cdrfiuba/marciano/src/README

Instalar libmanyuc en un directorio a la misma altura que el repositorio de Marciano
