cdrfiuba/marciano/src/eyes/MatthewPandina/schematics/README

Demystifying the TLC5940 - gEDA schematics

The schematics in the book were created using gEDA
(http://www.gpleda.org/), which is a set of electronic design
automation tools available for free under the GPL license.

Open the .sch files using gschem.
