cdrfiuba/marciano/src/eyes/MatthewPandina/code/ch3/README

Demystifying the TLC5940 - Chapter 3

Instructions:

  1. Verify that DEVICE, CLOCK, PROGRAMMER, and FUSES are set
     correctly in the Makefile based on your hardware. The provided
     Makefile is configured for an ATmega328P running at 18.432 MHz,
     using an AVR ISP mkII programmer, with FUSES set to remove the
     clock divider, and to use the external crystal.

  2. To build, type `make`

  3. To set the fuse bits, type `make fuse`

  4. To program the AVR, type `make flash`
