cdrfiuba/marciano/scad/orbitron.dxf

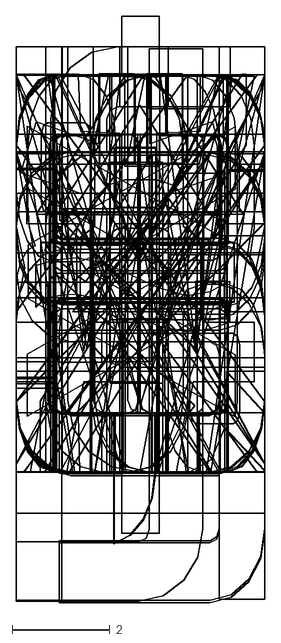
[picture p1: CAD file, 2015-04-26]
scad/orbitron.dxf
5.08 x 12.0
