cdrfiuba/marciano/(list of files, cad)

Other CAD files:
scad/Letters.dxf
scad/Write.scad
