cdrfiuba/marciano/src/eyes/MatthewPandina/schematics/multiplexing-multi.pdf

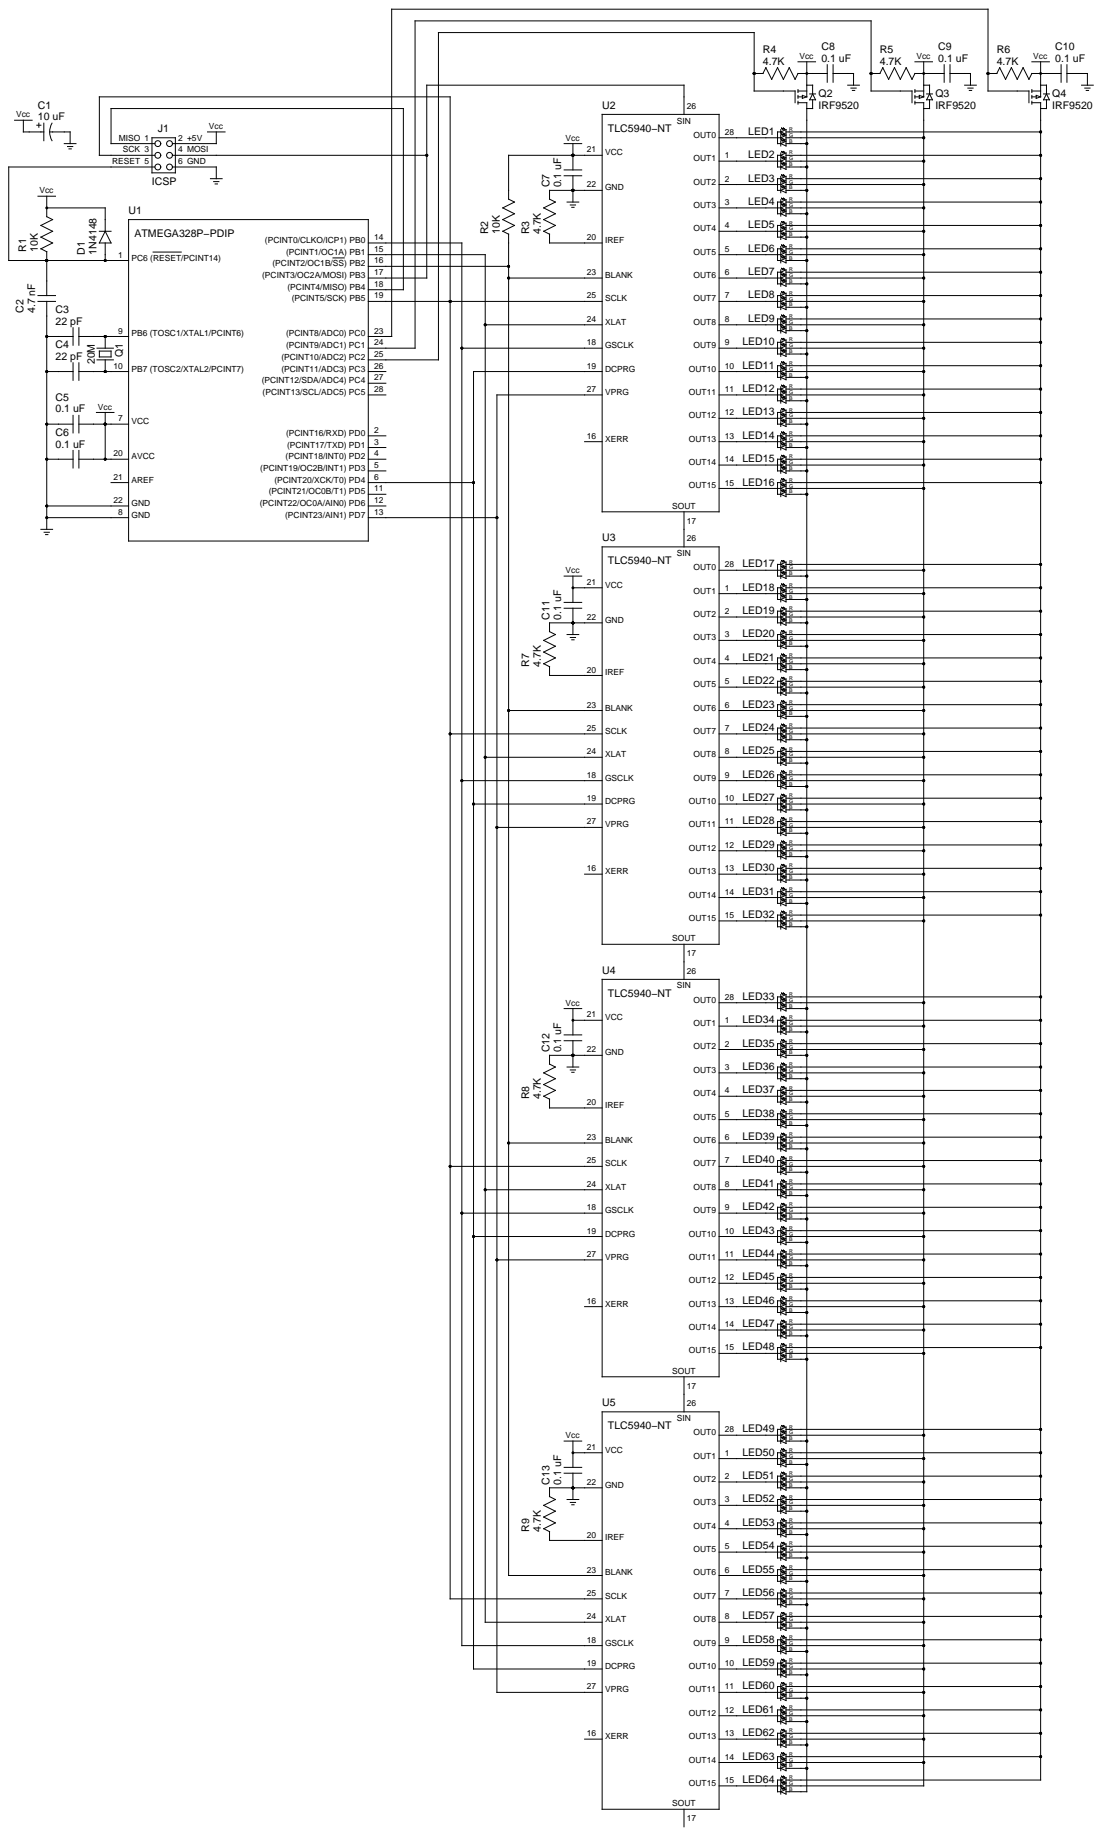
[picture p2: page 1]
