cdrfiuba/marciano/src/eyes/MatthewPandina/schematics/multiplexing.pdf

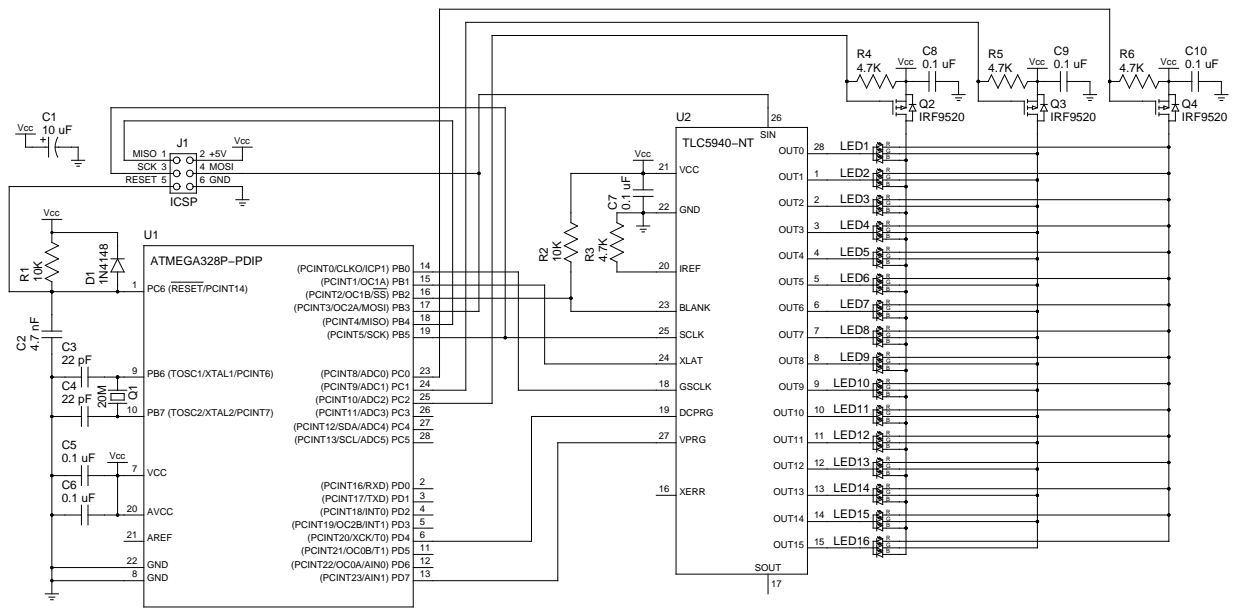
[picture p3: page 1]

15 (PCINT1/OC1A) PB1
16 (PCINT2/OC1B/SS) PB2
17 (PCINT3/OC2A/MOSI) PB3
18 (PCINT4/MISO) PB4
