cdrfiuba/marciano/src/eyes/MatthewPandina/schematics/no_border.pdf

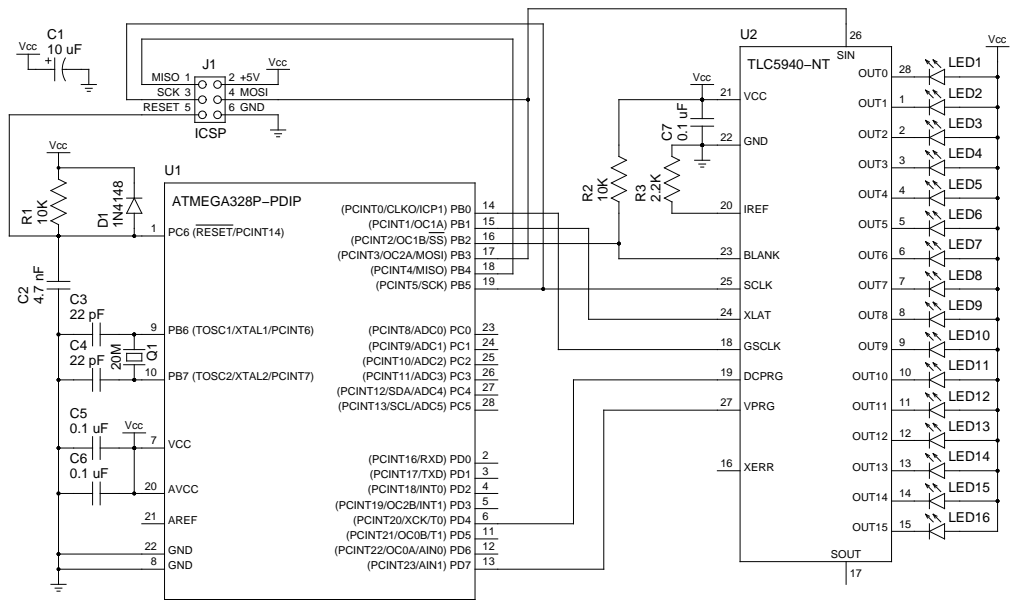
[picture p4: page 1]
