cdrfiuba/marciano/src/eyes/MatthewPandina/schematics/no_border_multiple.pdf

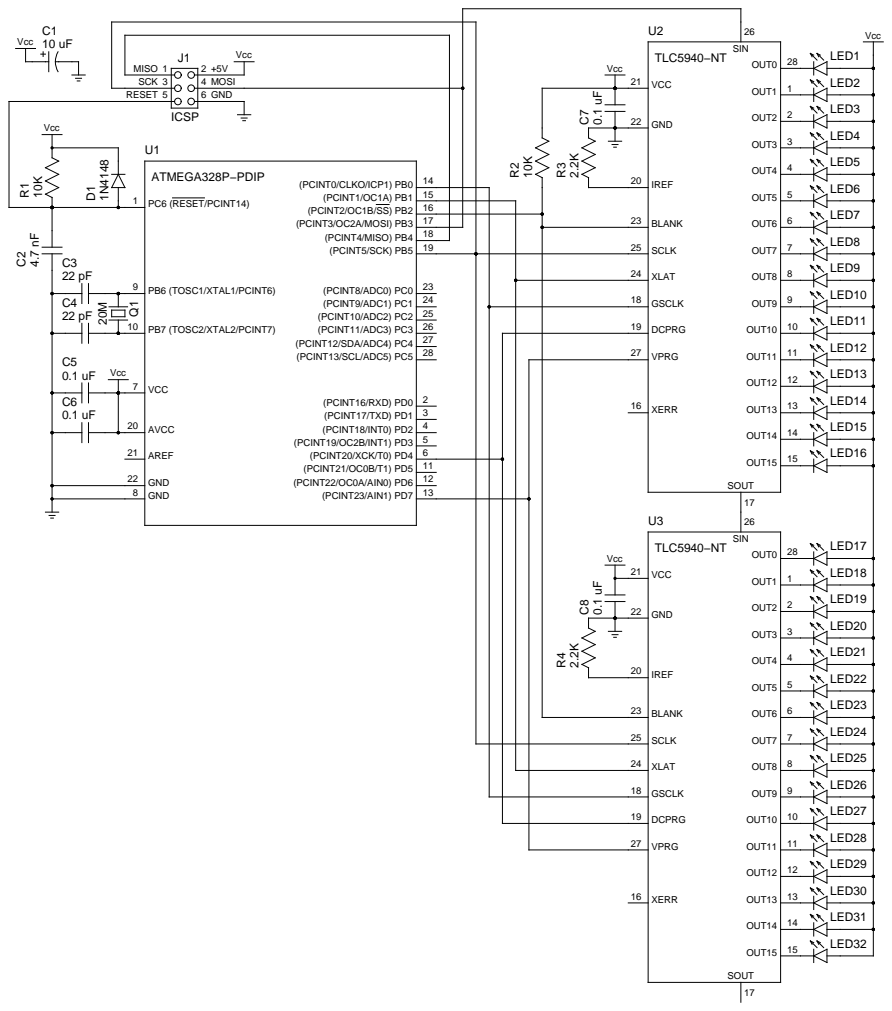
[picture p5: page 1]
