cdrfiuba/marciano/src/eyes/MatthewPandina/schematics/usart_mspim-multiplexing-multi.pdf

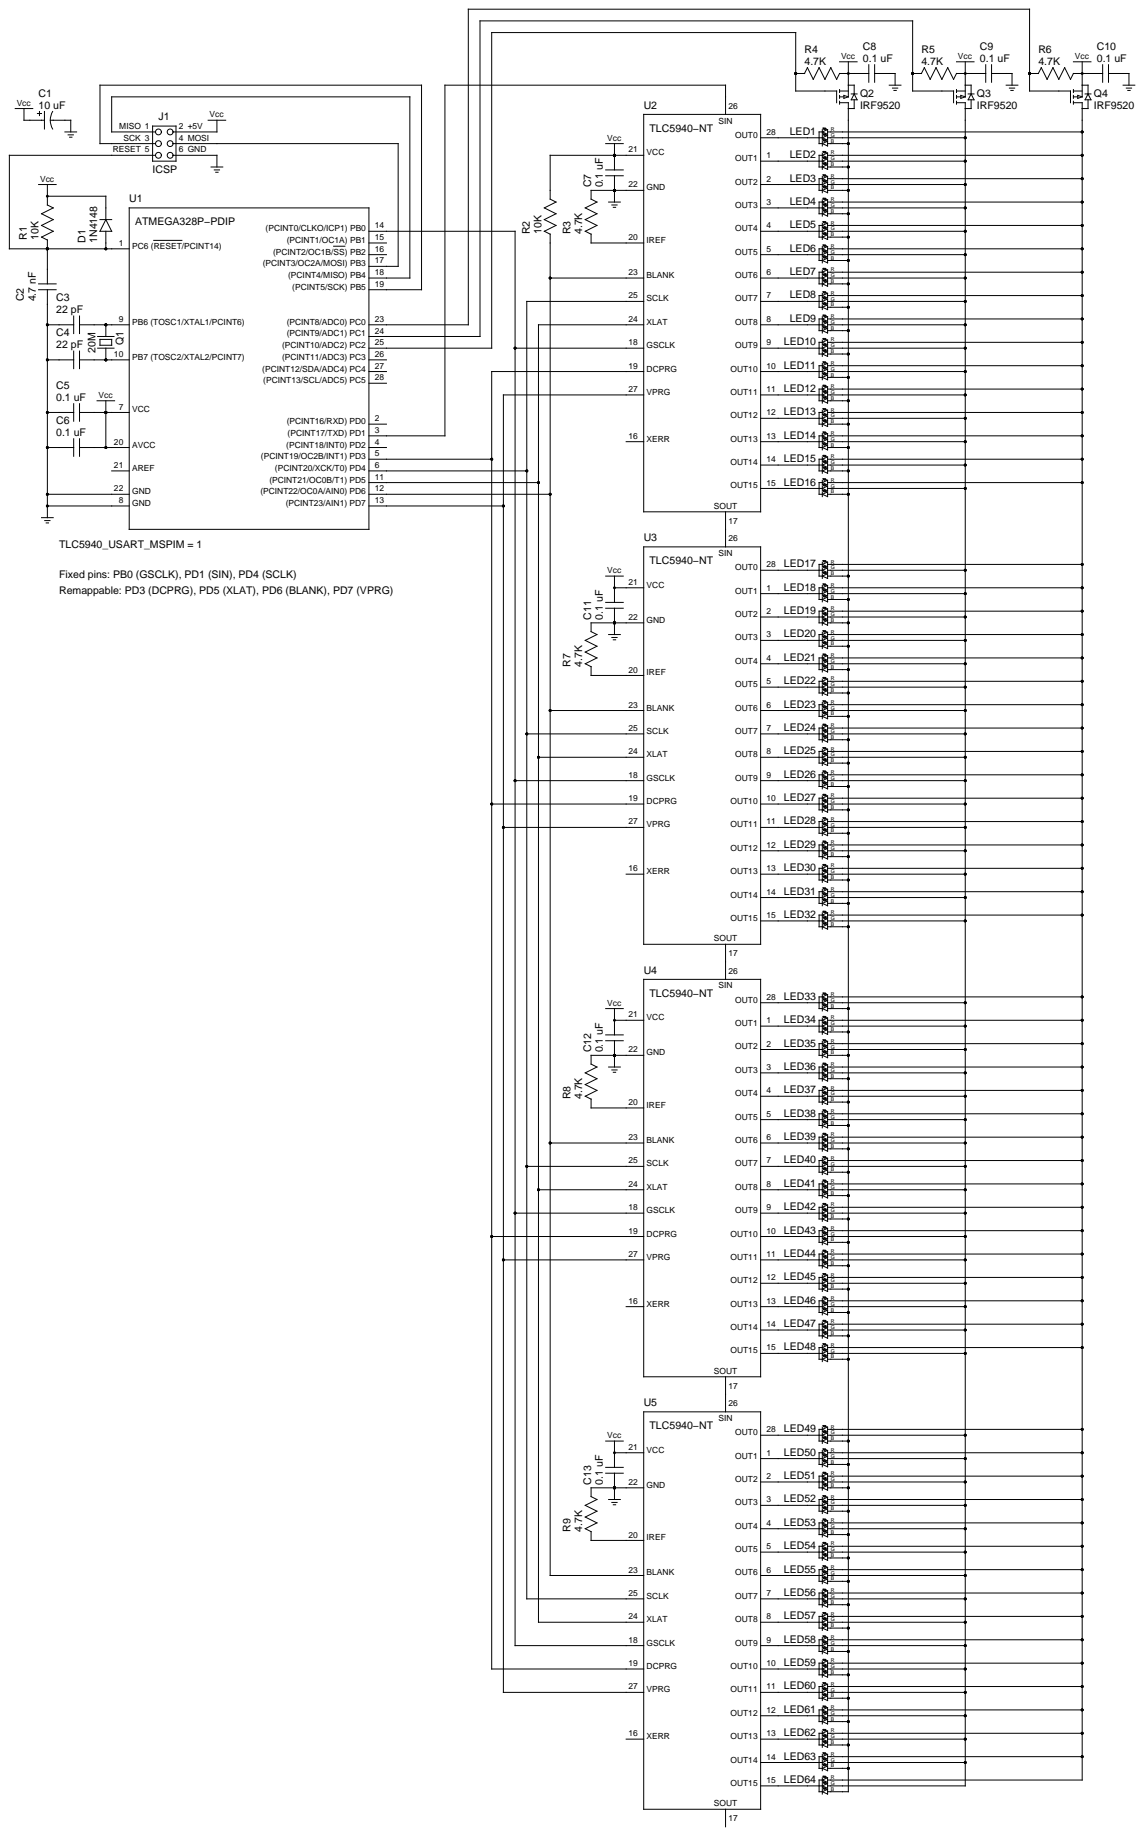
[picture p6: page 1]

11 (PCINT21/OC0B/T1) PD5
12 (PCINT22/OC0A/AIN0) PD6
13 (PCINT23/AIN1) PD7

Fixed pins: PB0 (GSCLK), PD1 (SIN), PD4 (SCLK)
Remappable: PD3 (DCPRG), PD5 (XLAT), PD6 (BLANK), PD7 (VPRG)
