cdrfiuba/marciano/pcbs/eyescontrol/eyescontrol.kicad_pcb

## KiCad design pcbs/eyescontrol/eyescontrol.kicad_pcb (2015-11-07)

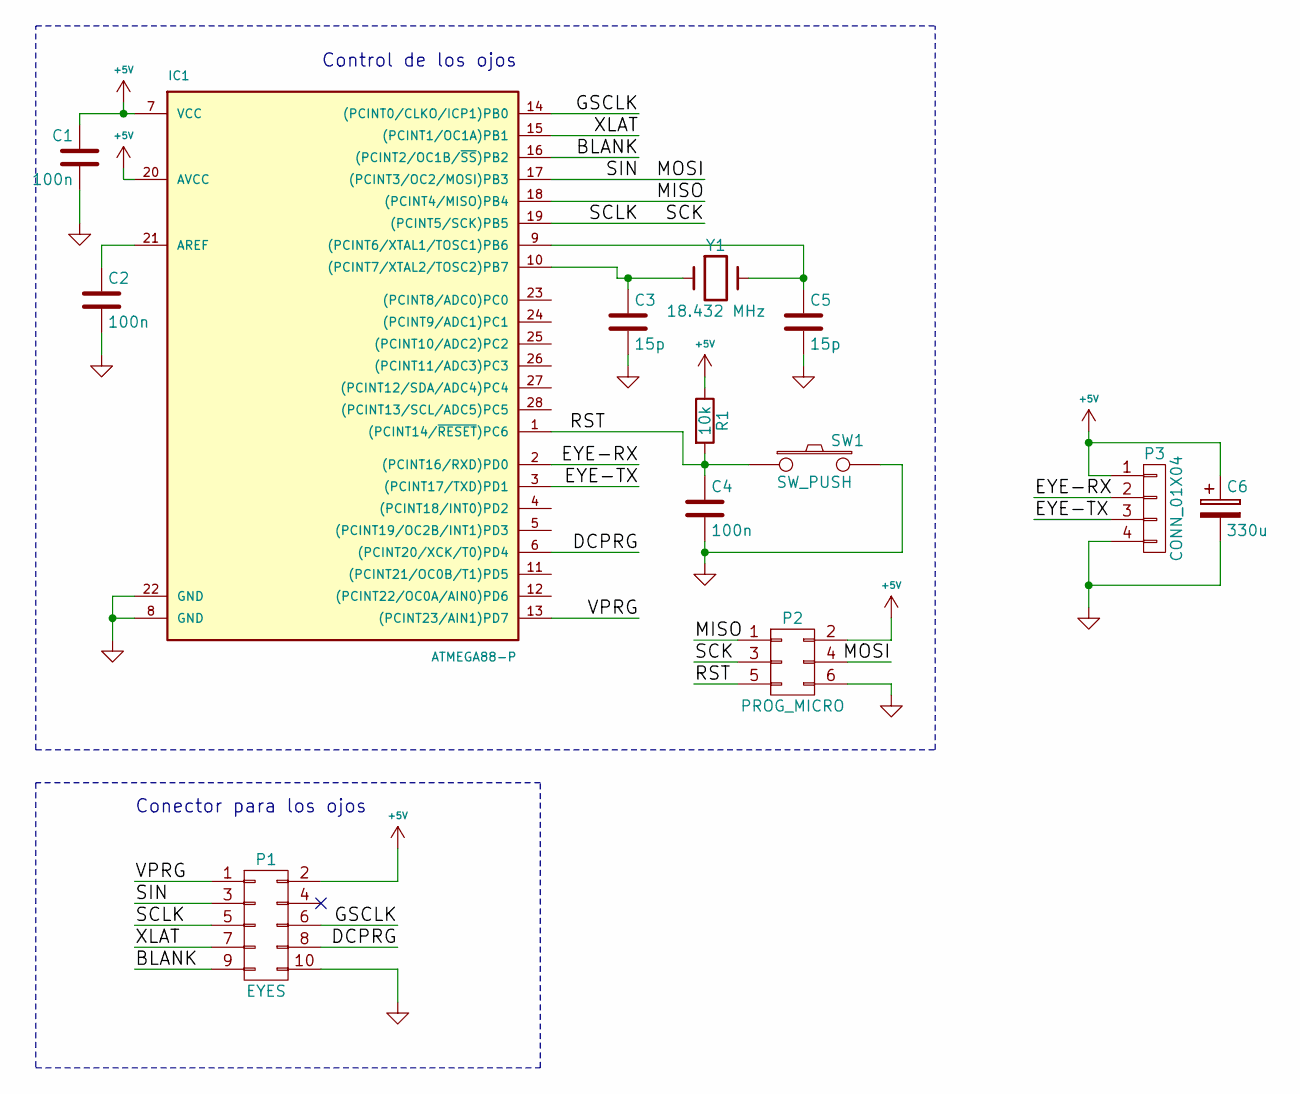
[picture p7: schematic eyescontrol.sch]

Parts:
C1, C2, C4: 100n; C_Rect_L4_W2.5_P2.5
C3, C5: 15p; C_Rect_L4_W2.5_P2.5
C6: 330u; C_Radial_D8_L11.5_P3.5
IC1: ATMEGA88-P; DIP-28__300
P1: EYES; Pin_Header_Straight_2x05
P2: PROG_MICRO; Pin_Header_Straight_2x03
P3: CONN_01X04; Socket_Strip_Straight_1x04
R1: 10k; Resistor_Horizontal_RM10mm
SW1: SW_PUSH; SW_PUSH_SMALL_m
Y1: 18.432 MHz; Crystal_HC49-U_Vertical

Connections:
+5V: C1.1, C6.1, IC1.7 (VCC), IC1.20 (AVCC), P1.2, P2.2, P3.1, R1.1
/BLANK: IC1.16 ((PCINT2/OC1B/~SS~)PB2), P1.9
/DCPRG: IC1.6 ((PCINT20/XCK/T0)PD4), P1.8
/EYE-RX: IC1.2 ((PCINT16/RXD)PD0), P3.2
/EYE-TX: IC1.3 ((PCINT17/TXD)PD1), P3.3
/GSCLK: IC1.14 ((PCINT0/CLKO/ICP1)PB0), P1.6
/MISO: IC1.18 ((PCINT4/MISO)PB4), P2.1
/MOSI: IC1.17 ((PCINT3/OC2/MOSI)PB3), P1.3, P2.4
/RST: C4.1, IC1.1 ((PCINT14/~RESET~)PC6), P2.5, R1.2, SW1.1
/SCK: IC1.19 ((PCINT5/SCK)PB5), P1.5, P2.3
/VPRG: IC1.13 ((PCINT23/AIN1)PD7), P1.1
/XLAT: IC1.15 ((PCINT1/OC1A)PB1), P1.7
GND: C1.2, C2.2, C3.2, C4.2, C5.2, C6.2, IC1.8 (GND), IC1.22 (GND), P1.10, P2.6, P3.4, SW1.2
unnamed: C2.1, IC1.21 (AREF)
unnamed: C3.1, IC1.10 ((PCINT7/XTAL2/TOSC2)PB7), Y1.1
unnamed: C5.1, IC1.9 ((PCINT6/XTAL1/TOSC1)PB6), Y1.2

Notes on the sheet:
Control de los ojos
Conector para los ojos

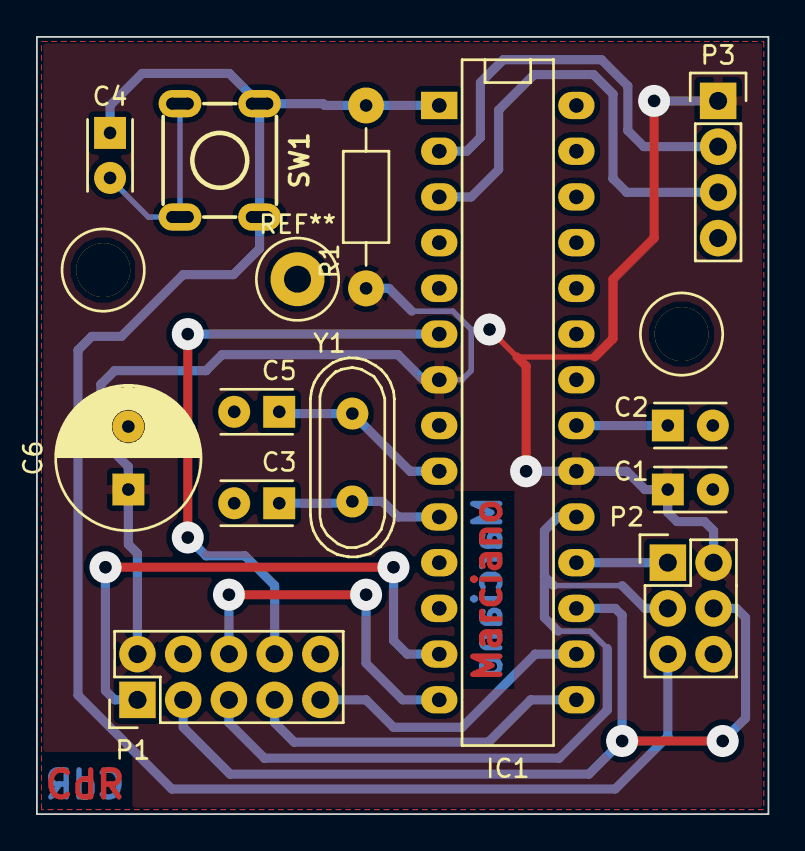
[picture p8: board eyescontrol.kicad_pcb from above]

Board: 2 copper layers, 40.6 x 43.2 mm, 13 parts (0 on the bottom side), 16 nets.
