cdrfiuba/marciano/pcbs/control_remoto/controlremoto.kicad_pcb

## KiCad design pcbs/control_remoto/controlremoto.kicad_pcb (2015-11-07)

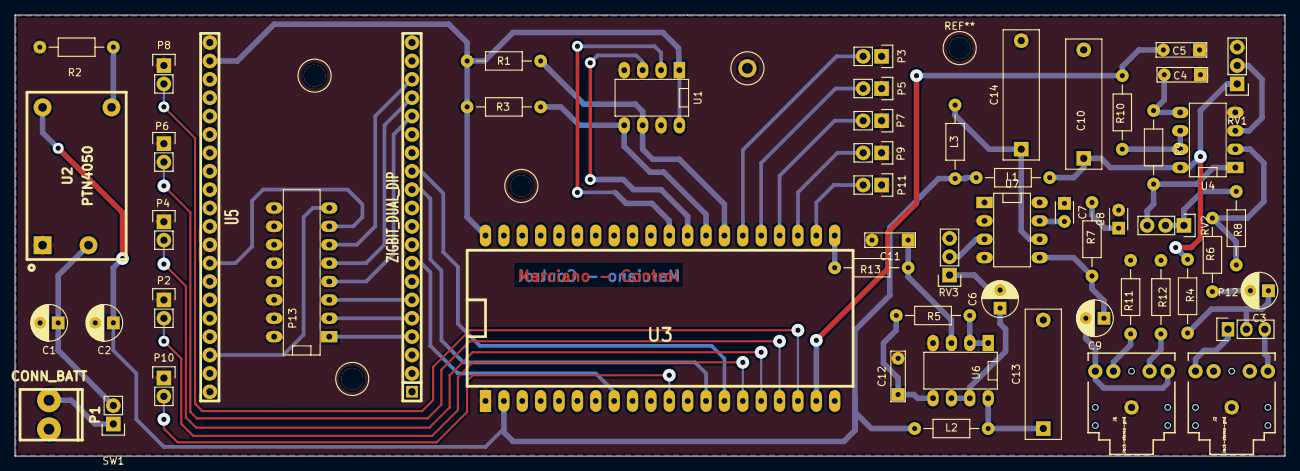
[picture p9: board controlremoto.kicad_pcb from above]

Board: 2 copper layers, 175.5 x 61.0 mm, 56 parts (0 on the bottom side), 58 nets.

Parts:
C1, C2: 100u; C_Radial_D5_L6_P2.5
C3, C6: 10u; C_Radial_D5_L6_P2.5
C4, C5: 100n; C_Rect_L7_W2_P5
C7: 100n; C_Disc_D3_P2.5
C8: 47n; C_Disc_D3_P2.5
C9: 220u; C_Radial_D5_L6_P2.5
C10, C13, C14: 1u; C_Rect_L18_W5_P15
C11, C12: 33n; C_Rect_L7_W2_P5
J1, J2: Jack-stereo-gnd; audio-jack-stereo
L1, L2, L3: 1u; Resistor_Horizontal_RM10mm
P1: CONN_BATT; molex_2_recto
P2: CONN_BTN00; Pin_Header_Straight_1x02
P3: CONN_BTN05; Pin_Header_Straight_1x02
P4: CONN_BTN01; Pin_Header_Straight_1x02
P5: CONN_BTN06; Pin_Header_Straight_1x02
P6: CONN_BTN02; Pin_Header_Straight_1x02
P7: CONN_BTN07; Pin_Header_Straight_1x02
P8: CONN_BTN03; Pin_Header_Straight_1x02
P9: CONN_BTN08; Pin_Header_Straight_1x02
P10: CONN_BTN04; Pin_Header_Straight_1x02
P11: CONN_BTN09; Pin_Header_Straight_1x02
P12: CONN_01X03; Socket_Strip_Straight_1x03
P13: DIPSWITCH; DIP-16__300_ELL
R1, R3: 2k2; Resistor_Horizontal_RM10mm
R2: inf; Resistor_Horizontal_RM10mm
R4: 2.2k; Resistor_Horizontal_RM10mm
R5, R6, R11, R12, R13: 1k; Resistor_Horizontal_RM10mm
R7: 10; Resistor_Horizontal_RM10mm
R8: 10k; Resistor_Horizontal_RM10mm
R9, R10: 820; Resistor_Horizontal_RM10mm
RV1: 100K; Pin_Header_Straight_1x03
RV2: 100k; Pin_Header_Straight_1x03
RV3: 10k; Pin_Header_Straight_1x03
SW1: ON/OFF; Pin_Header_Straight_1x02
U1: MMA7455L_DIP8; DIP-8__300_ELL
U2: PTN4050; PTN04050C-EUU
U3: MBED
U4, U6: TL082; DIP-8__300_ELL
U5: ZIGBIT_DUAL_DIP; ZIGBIT_DIP_40
U7: LM386_mod; DIP-8__300_ELL

Connections:
+3V3: R1.1, R3.1, U1.1, U1.8, U3.40, U5.22
+5V: C2.1, L1.1, L2.1, L3.1, U2.4, U3.2
+BATT: P1.2, SW1.1
/ACEL_INT1: U1.2, U3.30
/ACEL_INT2: U1.3, U3.29
/BTN_00: P2.2, U3.15
/BTN_01: P4.2, U3.16
/BTN_02: P6.2, U3.17
/BTN_03: P8.2, U3.18
/BTN_04: P10.2, U3.11
/BTN_05: P3.2, U3.26
/BTN_06: P5.2, U3.25
/BTN_07: P7.2, U3.24
/BTN_08: P9.2, U3.23
/BTN_09: P11.2, U3.22
/DIPSW_1: P13.1, U5.4
/DIPSW_2: P13.2, U5.5
/DIPSW_3: P13.3, U5.6
/DIPSW_4: P13.4, U5.16
/DIPSW_5: P13.5, U5.17
/DIPSW_6: P13.6, U5.18
/DIPSW_7: P13.7, U5.33
/DIPSW_8: P13.8, U5.38
/MIC: C5.2, R10.1, U3.19
/MicA: J2.2, P12.3
/MicB: J2.5, P12.1
/Parlante/IN: R13.2, U3.21
/Parlante/VCC2: C14.1, L3.2, U7.6
/Parlante/VCC3: C13.1, L2.2, U6.8
/SCL: R1.2, U1.6, U3.27
/SDA: R3.2, U1.5, U3.28
/VCC2: C10.1, L1.2, R4.1, RV1.1, U4.8
/ZB_RESET: U3.8, U5.8
/ZIGBIT_RX: U3.14, U5.13
/ZIGBIT_TX: U3.13, U5.12
GND: C1.2, C2.2, C4.1, C5.1, C7.1, C8.2, C10.2, C11.2, C12.2, C13.2, C14.2, J1.1, J2.1, P1.1, P2.1, P3.1, P4.1, P5.1, P6.1, P7.1, P8.1, P9.1, P10.1, P11.1, P13.9, P13.10, P13.11, P13.12, P13.13, P13.14, P13.15, P13.16, R2.2, R11.1, R12.1, RV1.3, RV3.3, U1.4, U1.7, U2.1, U3.1, U4.4, U5.21, U5.32, U6.4, U7.2, U7.4
unnamed: C1.1, SW1.2, U2.2
unnamed: C3.1, P12.2, R4.2
unnamed: C3.2, R6.2
unnamed: C4.2, R9.1, U4.5
unnamed: C6.1, U6.6, U6.7
unnamed: C6.2, RV3.1
unnamed: C7.2, U7.7
unnamed: C8.1, R7.2
unnamed: C9.1, R7.1, U7.5
unnamed: C9.2, J1.2, J1.5
unnamed: C11.1, R13.1, U6.3
unnamed: C12.1, R5.1, U6.5
unnamed: J1.3, R12.2
unnamed: J1.4, R11.2
unnamed: R2.1, U2.3
unnamed: R5.2, U6.1, U6.2
unnamed: R6.1, R8.2, U4.2
unnamed: R8.1, RV2.1, RV2.2
unnamed: R9.2, RV2.3, U4.1
unnamed: R10.2, U4.6, U4.7
unnamed: RV1.2, U4.3
unnamed: RV3.2, U7.3
