cdrfiuba/marciano/pcbs/basicmother/basicmother.kicad_pcb

## KiCad design pcbs/basicmother/basicmother.kicad_pcb (2015-11-07)

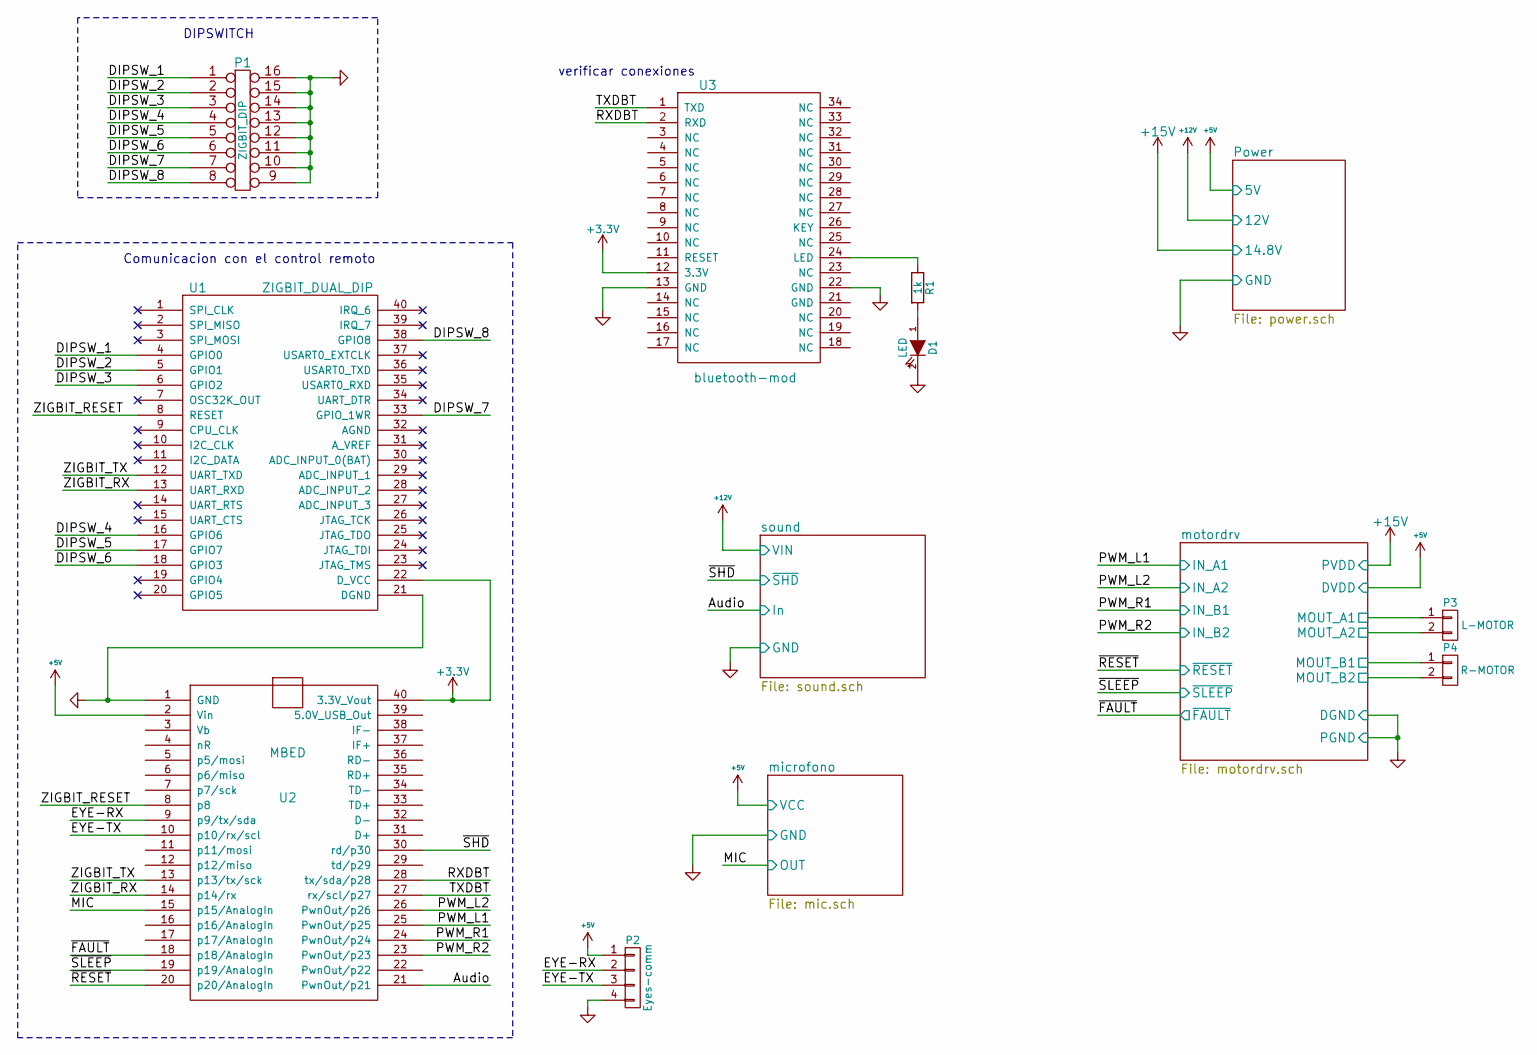
[picture p10: schematic basicmother.sch]

Parts:
D1: LED; LED-5MM
P1: ZIGBIT_DIP; DIP-16__300
P2: Eyes-comm; Socket_Strip_Straight_1x04
P3: L-MOTOR; Socket_Strip_Straight_1x02
P4: R-MOTOR; Socket_Strip_Straight_1x02
R1: 1k; Resistor_Horizontal_RM10mm
U1: ZIGBIT_DUAL_DIP; ZIGBIT_DIP_40
U2: MBED
U3: bluetooth-mod; Socket_Strip_Straight_2x17

Connections:
+3V3: U1.22 (D_VCC), U2.40 (3.3V_Vout), U3.12 (3.3V)
+5V: P2.1, U2.2 (Vin); also elsewhere on the board
/DIPSW_1: P1.1, U1.4 (GPIO0)
/DIPSW_2: P1.2, U1.5 (GPIO1)
/DIPSW_3: P1.3, U1.6 (GPIO2)
/DIPSW_4: P1.4, U1.16 (GPIO6)
/DIPSW_5: P1.5, U1.17 (GPIO7)
/DIPSW_6: P1.6, U1.18 (GPIO3)
/DIPSW_7: P1.7, U1.33 (GPIO_1WR)
/DIPSW_8: P1.8, U1.38 (GPIO8)
/EYE-RX: P2.2, U2.9 (p9/tx/sda)
/EYE-TX: P2.3, U2.10 (p10/rx/scl)
/RXDBT: U2.28 (tx/sda/p28), U3.2 (RXD)
/TXDBT: U2.27 (rx/scl/p27), U3.1 (TXD)
/ZIGBIT_RESET: U1.8 (RESET), U2.8 (p8)
/ZIGBIT_RX: U1.13 (UART_RXD), U2.14 (p14/rx)
/ZIGBIT_TX: U1.12 (UART_TXD), U2.13 (p13/tx/sck)
/microfono/OUT: U2.15 (p15/AnalogIn); also elsewhere on the board
/motordrv/IN_A1: U2.25 (PwnOut/p25); also elsewhere on the board
/motordrv/IN_A2: U2.26 (PwnOut/p26); also elsewhere on the board
/motordrv/IN_B1: U2.24 (PwnOut/p24); also elsewhere on the board
/motordrv/IN_B2: U2.23 (PwnOut/p23); also elsewhere on the board
/motordrv/MOUT_A1: P3.1; also elsewhere on the board
/motordrv/MOUT_A2: P3.2; also elsewhere on the board
/motordrv/MOUT_B1: P4.1; also elsewhere on the board
/motordrv/MOUT_B2: P4.2; also elsewhere on the board
/motordrv/~FAULT: U2.18 (p18/AnalogIn); also elsewhere on the board
/motordrv/~RESET: U2.20 (p20/AnalogIn); also elsewhere on the board
/motordrv/~SLEEP: U2.19 (p19/AnalogIn); also elsewhere on the board
/sound/In: U2.21 (PwnOut/p21); also elsewhere on the board
/sound/~SHD: U2.30 (rd/p30); also elsewhere on the board
GND: D1.2 (K), P1.9, P1.10, P1.11, P1.12, P1.13, P1.14, P1.15, P1.16, P2.4, U1.21 (DGND), U2.1 (GND), U3.13 (GND), U3.22 (GND); also elsewhere on the board
unnamed: D1.1 (A), R1.2
unnamed: R1.1, U3.24 (LED)

Notes on the sheet:
DIPSWITCH
Comunicacion con el control remoto
verificar conexiones

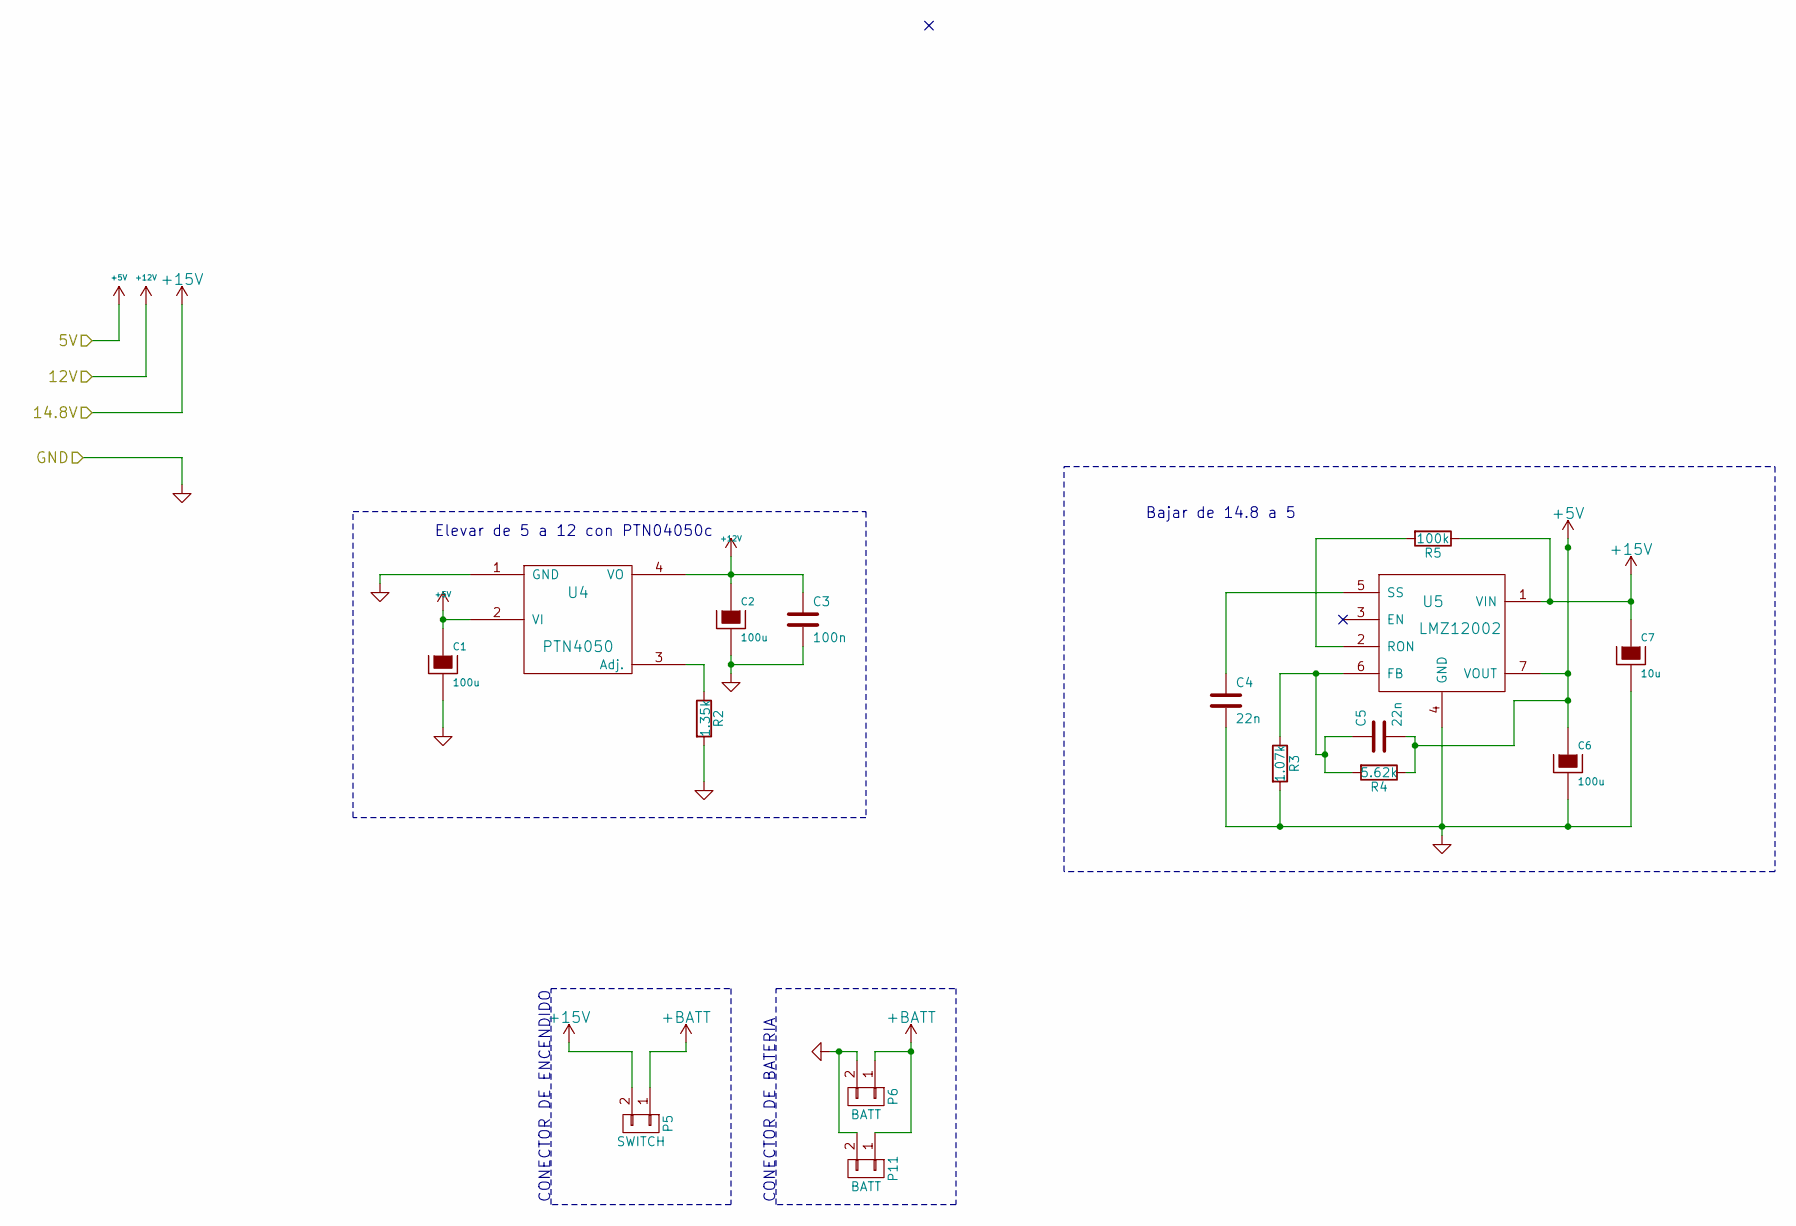
[picture p11: schematic power.sch]

Parts:
C1, C2, C6: 100u; C_Radial_D5_L6_P2.5
C3: 100n; C_Disc_D3_P2.5
C4, C5: 22n; C_Rect_L7_W2_P5
C7: 10u; C_Radial_D5_L6_P2.5
P5: SWITCH; Socket_Strip_Straight_1x02
P6: BATT; bornier2
P11: BATT; molex_2_recto
R2: 1.35k; Resistor_Horizontal_RM10mm
R3: 1.07k; Resistor_Horizontal_RM10mm
R4: 5.62k; Resistor_Horizontal_RM10mm
R5: 100k; Resistor_Horizontal_RM10mm
U4: PTN4050; PTN04050C-EUU
U5: LMZ12002; PFM7

Connections:
+5V: C1.1, C5.2, C6.1, R4.1, U4.2 (VI), U5.7 (VOUT); also elsewhere on the board
+12V: C2.1, C3.1, U4.4 (VO); also elsewhere on the board
+15V: C7.1, P5.2, R5.1, U5.1 (VIN); also elsewhere on the board
+BATT: P5.1, P6.1, P11.1
GND: C1.2, C2.2, C3.2, C4.2, C6.2, C7.2, P6.2, P11.2, R2.2, R3.2, U4.1 (GND), U5.4 (GND); also elsewhere on the board
unnamed: C4.1, U5.5 (SS)
unnamed: C5.1, R3.1, R4.2, U5.6 (FB)
unnamed: R2.1, U4.3 (Adj.)
unnamed: R5.2, U5.2 (RON)

Notes on the sheet:
Bajar de 14.8 a 5
Elevar de 5 a 12 con PTN04050c
CONECTOR DE BATERIA
CONECTOR DE ENCENDIDO

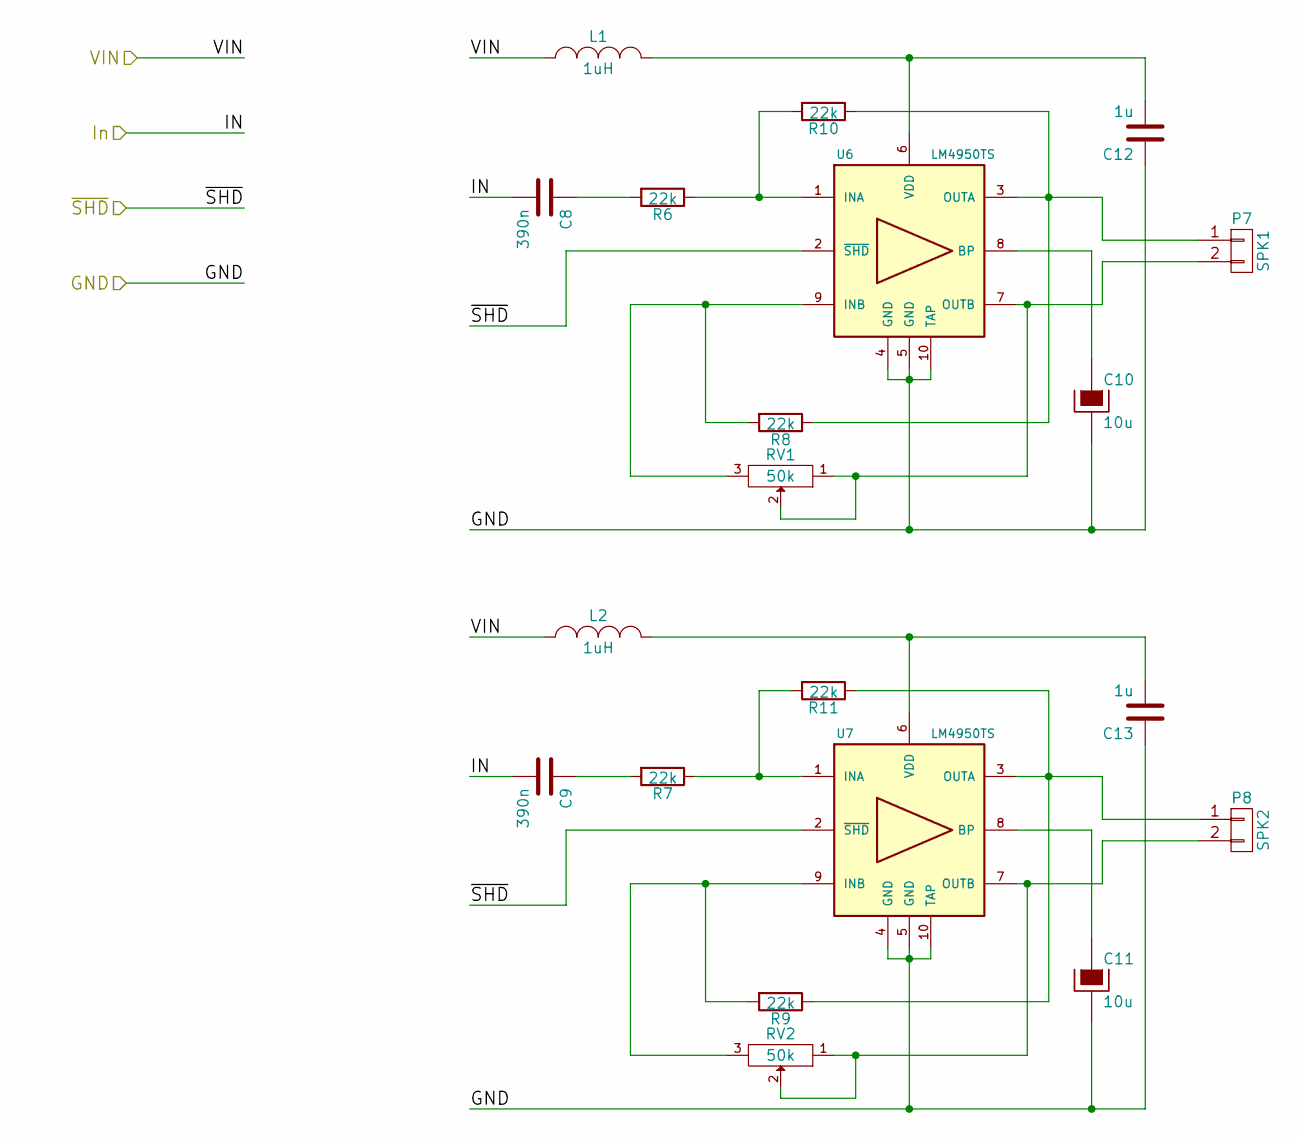
[picture p12: schematic sound.sch]

Parts:
C8, C9: 390n; C_Disc_D3_P2.5
C10, C11: 10u; C_Radial_D5_L6_P2.5
C12, C13: 1u; C_Rect_L18_W5_P15
L1, L2: 1uH; Resistor_Horizontal_RM10mm
P7: SPK1; Socket_Strip_Straight_1x02
P8: SPK2; Socket_Strip_Straight_1x02
R6, R7, R8, R9, R10, R11: 22k; Resistor_Horizontal_RM10mm
RV1, RV2: 50k; Socket_Strip_Straight_1x03
U6, U7: LM4950TS; TO-263

Connections:
+12V: L1.2, L2.2; also elsewhere on the board
/sound/In: C8.2, C9.2; also elsewhere on the board
/sound/~SHD: U6.2 (~SHD~), U7.2 (~SHD~); also elsewhere on the board
GND: C10.2, C11.2, C12.1, C13.1, U6.4 (GND), U6.5 (GND), U6.10 (TAP), U7.4 (GND), U7.5 (GND), U7.10 (TAP); also elsewhere on the board
unnamed: C8.1, R6.2
unnamed: C9.1, R7.2
unnamed: C10.1, U6.8 (BP)
unnamed: C11.1, U7.8 (BP)
unnamed: C12.2, L1.1, U6.6 (VDD)
unnamed: C13.2, L2.1, U7.6 (VDD)
unnamed: P7.1, R8.1, R10.1, U6.3 (OUTA)
unnamed: P7.2, RV1.1, RV1.2, U6.7 (OUTB)
unnamed: P8.1, R9.1, R11.1, U7.3 (OUTA)
unnamed: P8.2, RV2.1, RV2.2, U7.7 (OUTB)
unnamed: R8.2, RV1.3, U6.9 (INB)
unnamed: R9.2, RV2.3, U7.9 (INB)
unnamed: R6.1, R10.2, U6.1 (INA)
unnamed: R7.1, R11.2, U7.1 (INA)

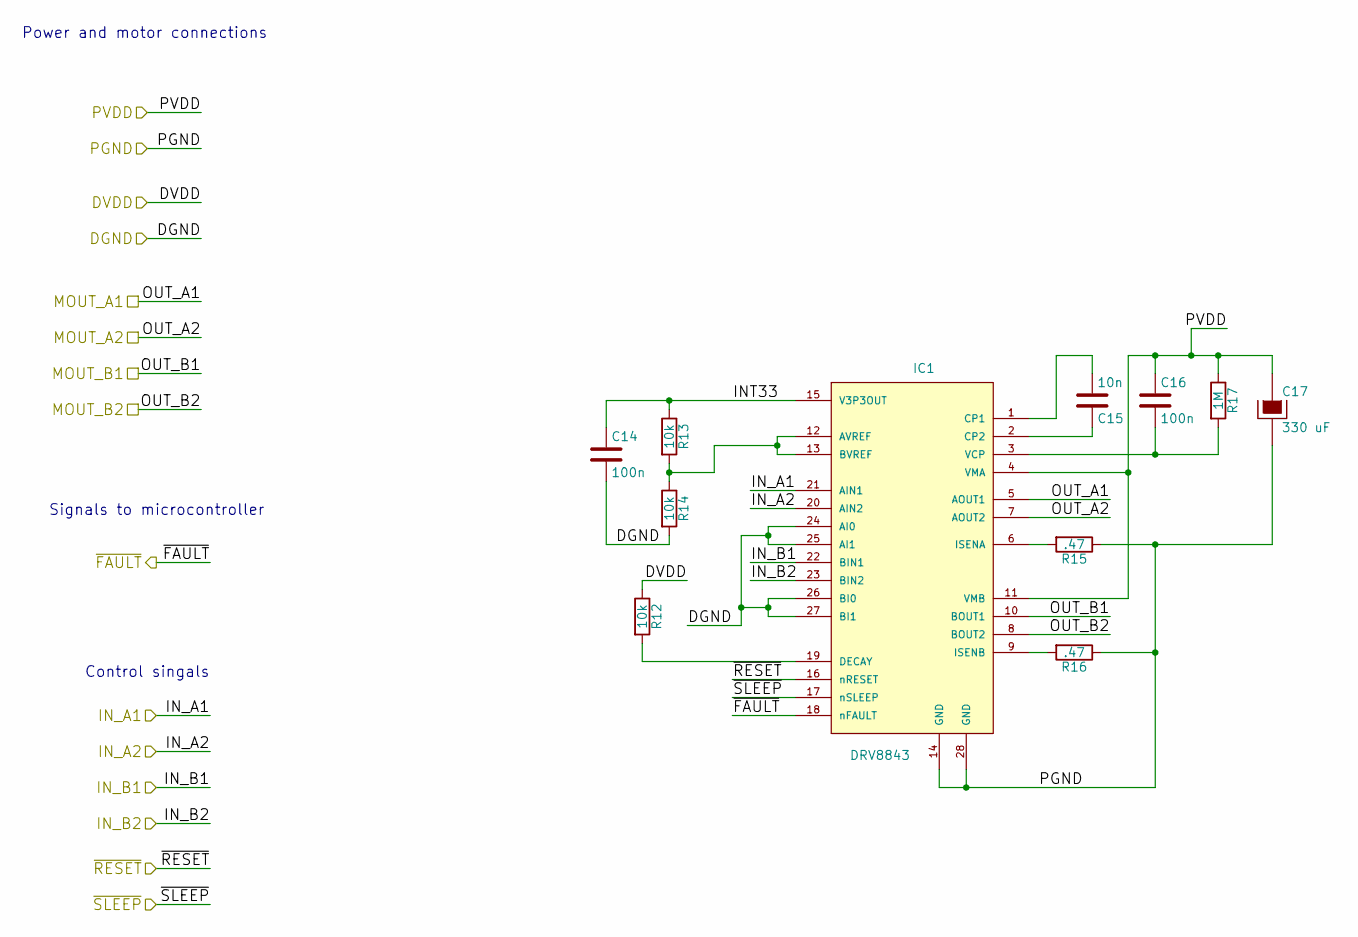
[picture p13: schematic motordrv.sch, Dual H-Bridge]

Parts:
C14, C16: 100n; C_Disc_D3_P2.5
C15: 10n; C_Disc_D3_P2.5
C17: 330 uF; C_Radial_D5_L6_P2.5
IC1: DRV8843; HTSSOP28
R12, R13, R14: 10k; Resistor_Horizontal_RM10mm
R15, R16: .47; Resistor_Horizontal_RM15mm
R17: 1M; Resistor_Horizontal_RM10mm

Connections:
+5V: R12.1; also elsewhere on the board
+15V: C16.1, C17.1, IC1.4 (VMA), IC1.11 (VMB), R17.1; also elsewhere on the board
/motordrv/INT33: C14.1, IC1.15 (V3P3OUT), R13.1
/motordrv/IN_A1: IC1.21 (AIN1); also elsewhere on the board
/motordrv/IN_A2: IC1.20 (AIN2); also elsewhere on the board
/motordrv/IN_B1: IC1.22 (BIN1); also elsewhere on the board
/motordrv/IN_B2: IC1.23 (BIN2); also elsewhere on the board
/motordrv/MOUT_A1: IC1.5 (AOUT1); also elsewhere on the board
/motordrv/MOUT_A2: IC1.7 (AOUT2); also elsewhere on the board
/motordrv/MOUT_B1: IC1.10 (BOUT1); also elsewhere on the board
/motordrv/MOUT_B2: IC1.8 (BOUT2); also elsewhere on the board
/motordrv/~FAULT: IC1.18 (nFAULT); also elsewhere on the board
/motordrv/~RESET: IC1.16 (nRESET); also elsewhere on the board
/motordrv/~SLEEP: IC1.17 (nSLEEP); also elsewhere on the board
GND: C14.2, C17.2, IC1.14 (GND), IC1.24 (AI0), IC1.25 (AI1), IC1.26 (BI0), IC1.27 (BI1), IC1.28 (GND), R14.2, R15.1, R16.1; also elsewhere on the board
unnamed: C15.1, IC1.2 (CP2)
unnamed: C15.2, IC1.1 (CP1)
unnamed: C16.2, IC1.3 (VCP), R17.2
unnamed: IC1.6 (ISENA), R15.2
unnamed: IC1.9 (ISENB), R16.2
unnamed: IC1.12 (AVREF), IC1.13 (BVREF), R13.2, R14.1
unnamed: IC1.19 (DECAY), R12.2

Notes on the sheet:
Power and motor connections
Control singals
Signals to microcontroller

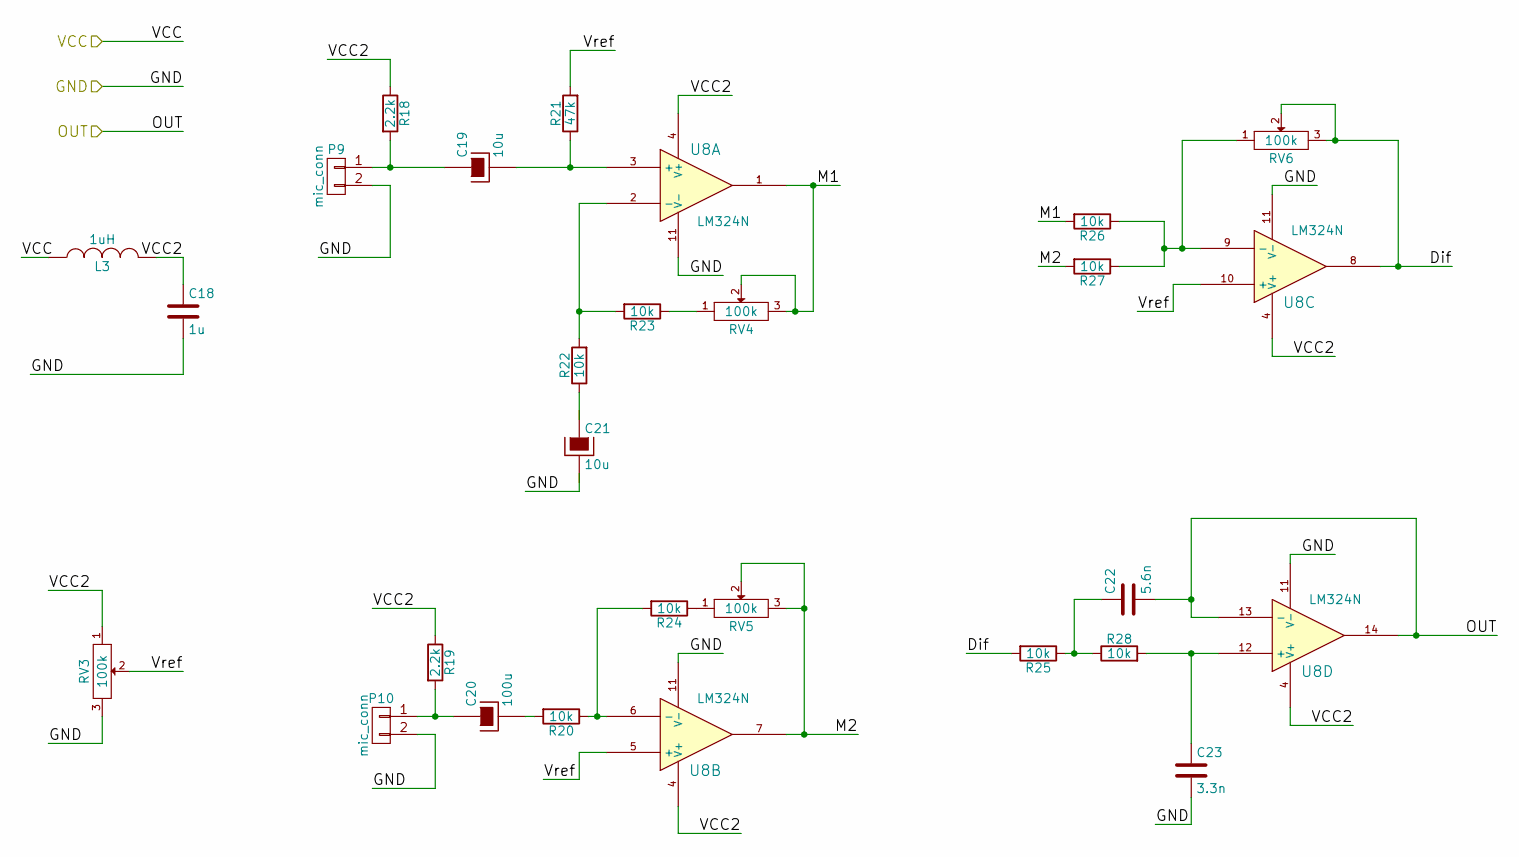
[picture p14: schematic mic.sch]

Parts:
C18: 1u; C_Rect_L18_W5_P15
C19, C21: 10u; C_Radial_D5_L6_P2.5
C20: 100u; C_Radial_D5_L6_P2.5
C22: 5.6n; C_Disc_D3_P2.5
C23: 3.3n; C_Disc_D3_P2.5
L3: 1uH; Resistor_Horizontal_RM10mm
P9, P10: mic_conn; Socket_Strip_Straight_1x02
R18, R19: 2.2k; Resistor_Horizontal_RM10mm
R20, R22, R23, R24, R25, R26, R27, R28: 10k; Resistor_Horizontal_RM10mm
R21: 47k; Resistor_Horizontal_RM10mm
RV3, RV4, RV5, RV6: 100k; Socket_Strip_Straight_1x03
U8: LM324N; DIP-14__300_ELL

Connections:
+5V: L3.1; also elsewhere on the board
/microfono/Dif: R25.2, RV6.2, RV6.3, U8.8
/microfono/M1: R26.2, RV4.2, RV4.3, U8.1
/microfono/M2: R27.2, RV5.2, RV5.3, U8.7
/microfono/OUT: C22.2, U8.13 (-), U8.14; also elsewhere on the board
/microfono/VCC2: C18.1, L3.2, R18.1, R19.1, RV3.1, U8.4 (V+)
/microfono/Vref: R21.2, RV3.2, U8.5 (+), U8.10 (+)
GND: C18.2, C21.2, C23.2, P9.2, P10.2, RV3.3, U8.11 (V-); also elsewhere on the board
unnamed: C19.1, P9.1, R18.2
unnamed: C19.2, R21.1, U8.3 (+)
unnamed: C20.1, P10.1, R19.2
unnamed: C20.2, R20.2
unnamed: C21.1, R22.1
unnamed: C22.1, R25.1, R28.1
unnamed: C23.1, R28.2, U8.12 (+)
unnamed: R20.1, R24.2, U8.6 (-)
unnamed: R22.2, R23.2, U8.2 (-)
unnamed: R23.1, RV4.1
unnamed: R24.1, RV5.1
unnamed: R26.1, R27.1, RV6.1, U8.9 (-)

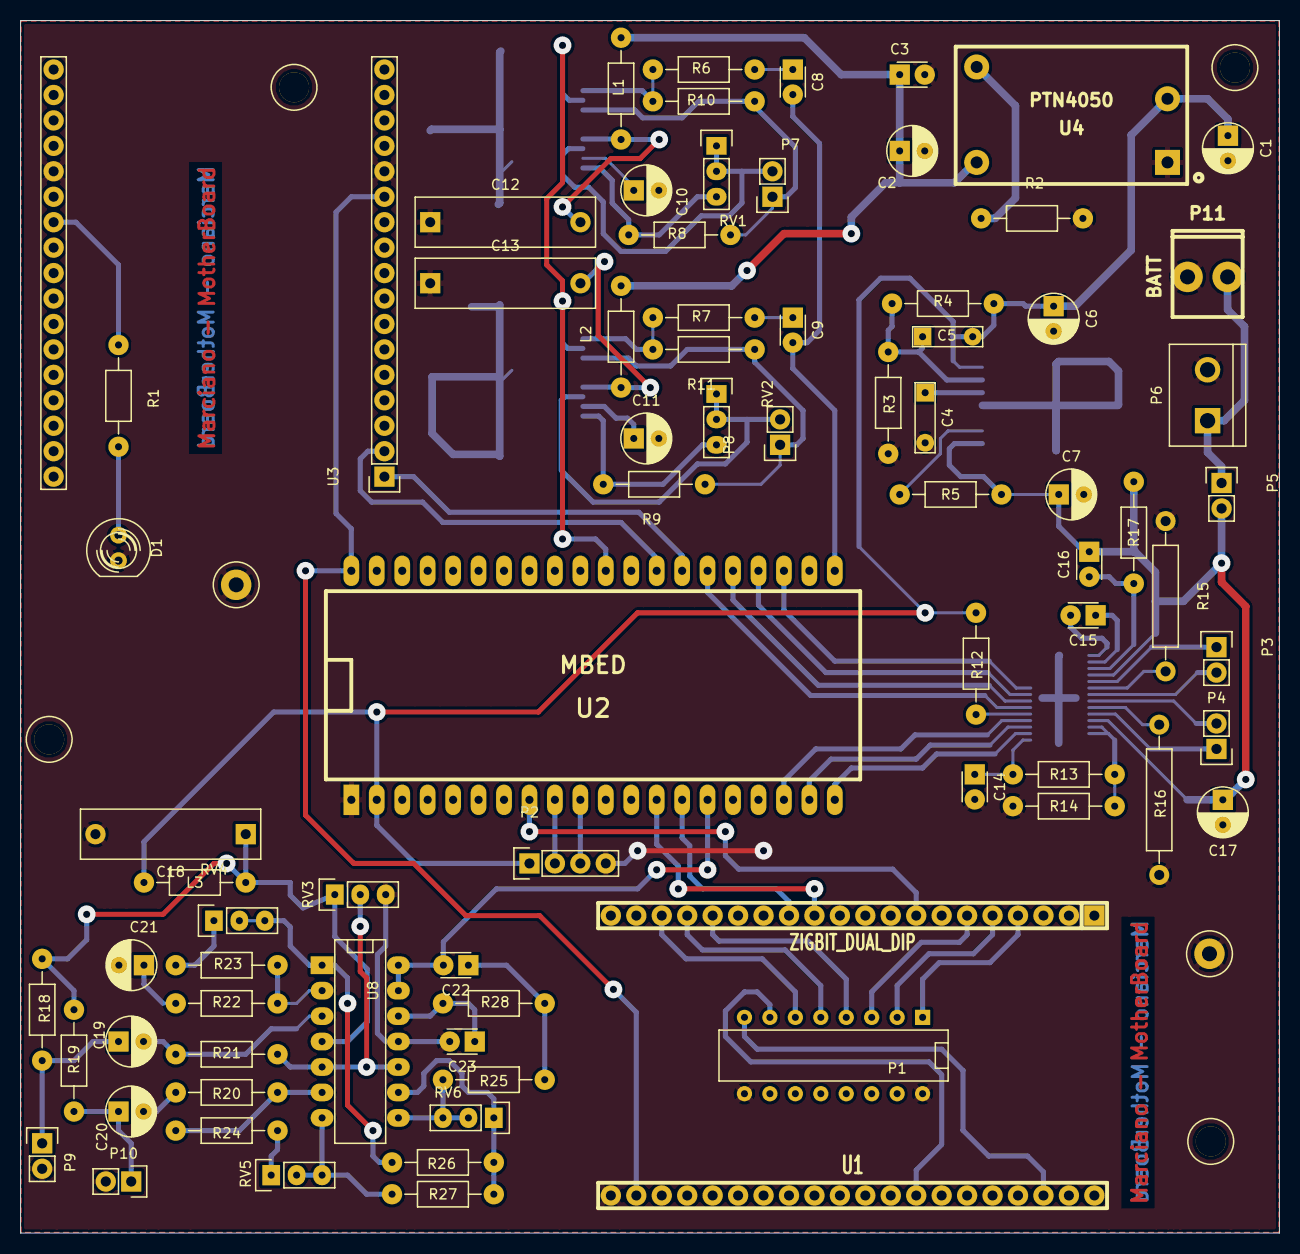
[picture p15: board basicmother.kicad_pcb from above]

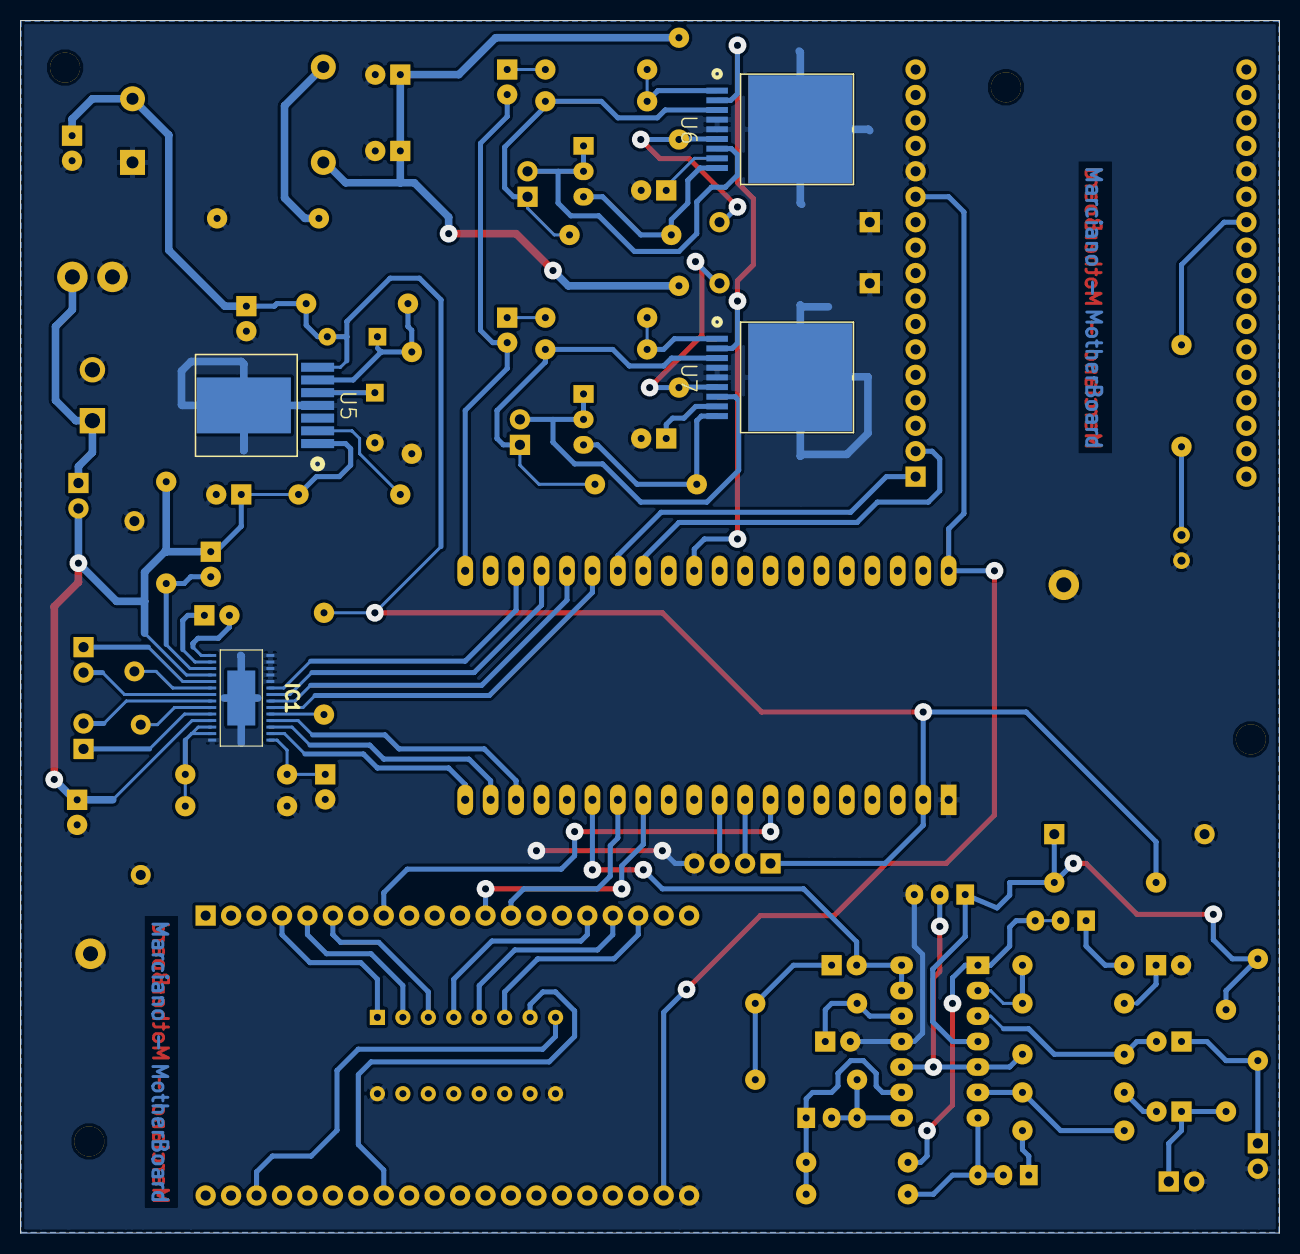
[picture p16: board basicmother.kicad_pcb from below]

Board: 2 copper layers, 125.7 x 121.0 mm, 81 parts (4 on the bottom side), 80 nets.
