cdrfiuba/marciano/pcbs/eyesunicolor/eyesunicolor.kicad_pcb

## KiCad design pcbs/eyesunicolor/eyesunicolor.kicad_pcb (2015-04-25)

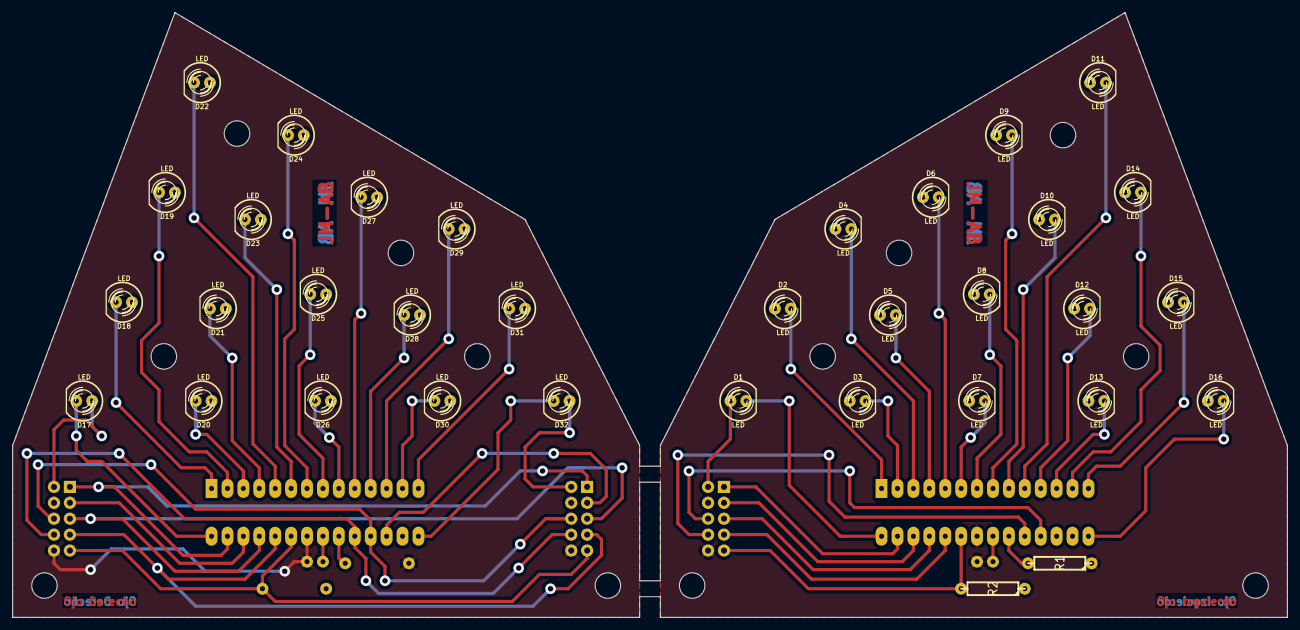
[picture p17: board eyesunicolor.kicad_pcb from above]

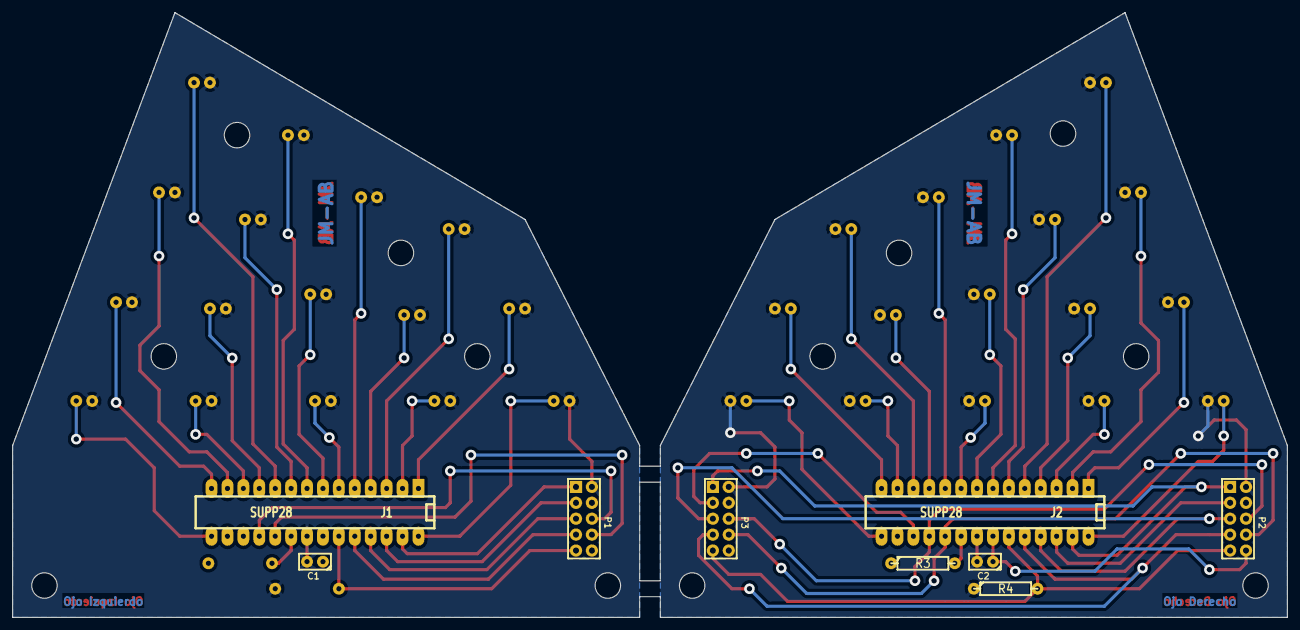
[picture p18: board eyesunicolor.kicad_pcb from below]

Board: 2 copper layers, 203.5 x 96.5 mm, 43 parts (9 on the bottom side), 51 nets.

Parts:
C1, C2: 100n; C1
D1, D2, D3, D4, D5, D6, D7, D8, D9, D10, D11, D12, D13, D14, D15, D16, D17, D18, D19, D20, D21, D22, D23, D24, D25, D26, D27, D28, D29, D30, D31, D32: LED; LED-5MM
J1, J2: SUPP28; DIP-28__300_ELL
P1, P2, P3: CONN_5X2; PIN_ARRAY_5x2
R1, R3: 2.2k; R4-LARGE_PADS
R2, R4: 10k; R4-LARGE_PADS

Connections:
/BLANK_D: J2.23, P2.9, P3.9, R4.2
/BLANK_I: J1.23, P1.9, R2.2
/DCPRG_D: J2.19, P2.8, P3.8
/DCPRG_I: J1.19, P1.8
/GSCLK_D: J2.18, P2.6, P3.6
/GSCLK_I: J1.18, P1.6
/SCLK_D: J2.25, P2.5, P3.5
/SCLK_I: J1.25, P1.5
/SIN_D: J2.26, P2.3
/SIN_I: J1.26, P1.3
/SOUT_D: J2.17, P3.3
/VPRG_D: J2.27, P2.1, P3.1
/VPRG_I: J1.27, P1.1
/XLAT_D: J2.24, P2.7, P3.7
/XLAT_I: J1.24, P1.7
GND: C1.1, C2.1, J1.22, J2.22, P1.10, P2.10, P3.10, R1.1, R3.1
unnamed: J2.20, R3.2
unnamed: J1.20, R1.2
unnamed: D30.2, J2.13
unnamed: D1.2, J1.28
unnamed: D15.2, J1.14
unnamed: D11.2, J1.10
unnamed: D16.2, J1.15
unnamed: D4.2, J1.3
unnamed: D8.2, J1.7
unnamed: D6.2, J1.5
unnamed: D12.2, J1.11
unnamed: D14.2, J1.13
unnamed: D13.2, J1.12
unnamed: D10.2, J1.9
unnamed: D9.2, J1.8
unnamed: D7.2, J1.6
unnamed: D5.2, J1.4
unnamed: D3.2, J1.2
unnamed: D2.2, J1.1
unnamed: D23.2, J2.6
unnamed: D26.2, J2.9
unnamed: D29.2, J2.12
unnamed: D28.2, J2.11
unnamed: D17.2, J2.28
unnamed: D27.2, J2.10
unnamed: D18.2, J2.1
unnamed: D32.2, J2.15
unnamed: D31.2, J2.14
unnamed: D20.2, J2.3
unnamed: D21.2, J2.4
unnamed: D24.2, J2.7
unnamed: D25.2, J2.8
unnamed: D22.2, J2.5
unnamed: D19.2, J2.2
VCC: C1.2, C2.2, D1.1, D2.1, D3.1, D4.1, D5.1, D6.1, D7.1, D8.1, D9.1, D10.1, D11.1, D12.1, D13.1, D14.1, D15.1, D16.1, D17.1, D18.1, D19.1, D20.1, D21.1, D22.1, D23.1, D24.1, D25.1, D26.1, D27.1, D28.1, D29.1, D30.1, D31.1, D32.1, J1.21, J2.21, P1.2, P2.2, P3.2, R2.1, R4.1
