cdrfiuba/marciano/pcbs/basicmother/basicmother.sch

## KiCad design pcbs/basicmother/basicmother.sch (2015-11-07, an earlier design)

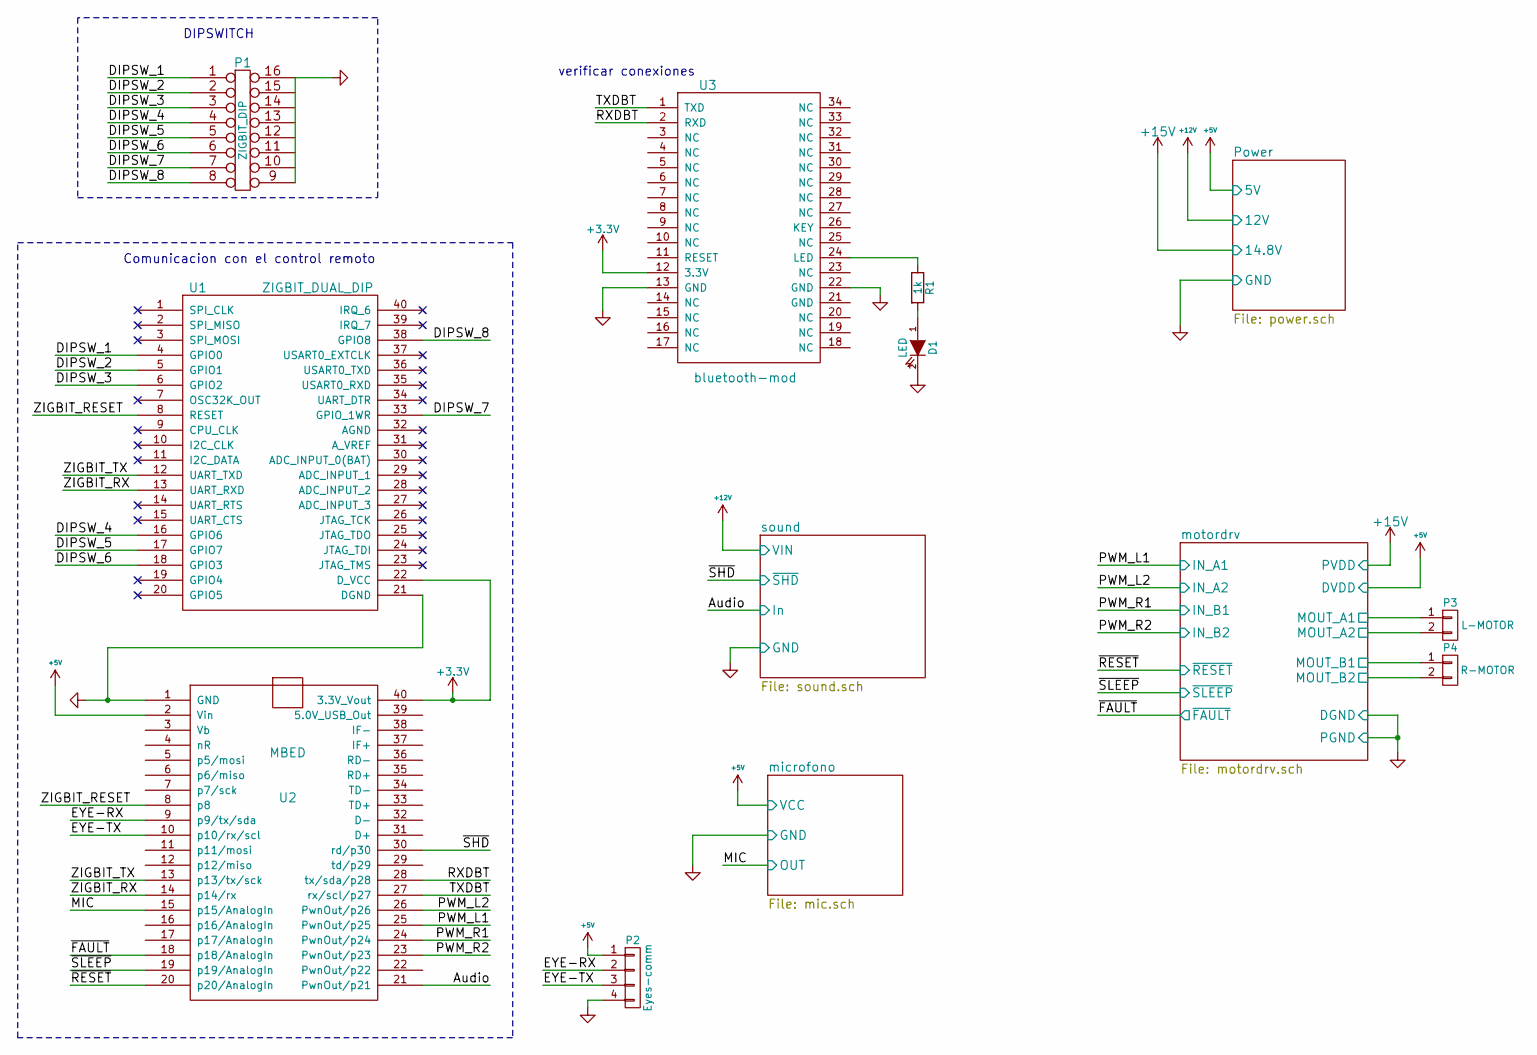
[picture p19: schematic basicmother.sch]

Parts:
D1: LED; LED-5MM
P1: ZIGBIT_DIP; DIP-16__300
P2: Eyes-comm; Socket_Strip_Straight_1x04
P3: L-MOTOR; Socket_Strip_Straight_1x02
P4: R-MOTOR; Socket_Strip_Straight_1x02
R1: 1k; Resistor_Horizontal_RM10mm
U1: ZIGBIT_DUAL_DIP; ZIGBIT_DIP_40
U2: MBED
U3: bluetooth-mod; Socket_Strip_Straight_2x17

Connections:
+3.3V: U1.22 (D_VCC), U2.40 (3.3V_Vout), U3.12 (3.3V)
+5V: P2.1, U2.2 (Vin)
Audio: U2.21 (PwnOut/p21)
DIPSW_1: P1.1, U1.4 (GPIO0)
DIPSW_2: P1.2, U1.5 (GPIO1)
DIPSW_3: P1.3, U1.6 (GPIO2)
DIPSW_4: P1.4, U1.16 (GPIO6)
DIPSW_5: P1.5, U1.17 (GPIO7)
DIPSW_6: P1.6, U1.18 (GPIO3)
DIPSW_7: P1.7, U1.33 (GPIO_1WR)
DIPSW_8: P1.8, U1.38 (GPIO8)
EYE-RX: P2.2, U2.9 (p9/tx/sda)
EYE-TX: P2.3, U2.10 (p10/rx/scl)
GND: D1.2 (K), P1.9, P1.16, P2.4, U1.21 (DGND), U2.1 (GND), U3.13 (GND), U3.22 (GND)
MIC: U2.15 (p15/AnalogIn)
MOUT_A1: P3.1
MOUT_A2: P3.2
MOUT_B1: P4.1
MOUT_B2: P4.2
unnamed: D1.1 (A), R1.2
unnamed: R1.1, U3.24 (LED)
PWM_L1: U2.25 (PwnOut/p25)
PWM_L2: U2.26 (PwnOut/p26)
PWM_R1: U2.24 (PwnOut/p24)
PWM_R2: U2.23 (PwnOut/p23)
RXDBT: U2.28 (tx/sda/p28), U3.2 (RXD)
TXDBT: U2.27 (rx/scl/p27), U3.1 (TXD)
ZIGBIT_RESET: U1.8 (RESET), U2.8 (p8)
ZIGBIT_RX: U1.13 (UART_RXD), U2.14 (p14/rx)
ZIGBIT_TX: U1.12 (UART_TXD), U2.13 (p13/tx/sck)
~FAULT: U2.18 (p18/AnalogIn)
~RESET: U2.20 (p20/AnalogIn)
~SHD: U2.30 (rd/p30)
~SLEEP: U2.19 (p19/AnalogIn)

Notes on the sheet:
DIPSWITCH
Comunicacion con el control remoto
verificar conexiones
