cdrfiuba/marciano/pcbs/basicmother/mic.sch

## KiCad design pcbs/basicmother/mic.sch (2015-04-25)


Parts:
C18: 1u; C_Rect_L18_W5_P15
C19, C21: 10u; C_Radial_D5_L6_P2.5
C20: 100u; C_Radial_D5_L6_P2.5
C22: 5.6n; C_Disc_D3_P2.5
C23: 3.3n; C_Disc_D3_P2.5
L3: 1uH; Resistor_Horizontal_RM10mm
P9, P10: mic_conn; Socket_Strip_Straight_1x02
R18, R19: 2.2k; Resistor_Horizontal_RM10mm
R20, R22, R23, R24, R25, R26, R27, R28: 10k; Resistor_Horizontal_RM10mm
R21: 47k; Resistor_Horizontal_RM10mm
RV3, RV4, RV5, RV6: 100k; Socket_Strip_Straight_1x03
U8: LM324N; DIP-14__300_ELL

Connections:
Dif: R25.2, RV6.2, RV6.3, U8.8
GND: C18.2, C23.2, P9.2, P10.2, RV3.3, U8.11 (V-)
M1: R26.2, RV4.2, RV4.3, U8.1
M2: R27.2, RV5.2, RV5.3, U8.7
unnamed: C19.1, P9.1, R18.2
unnamed: C19.2, R21.1, U8.3 (+)
unnamed: C20.1, P10.1, R19.2
unnamed: C20.2, R20.2
unnamed: C22.1, R25.1, R28.1
unnamed: C23.1, R28.2, U8.12 (+)
unnamed: R20.1, R24.2, U8.6 (-)
unnamed: R22.2, R23.2, U8.2 (-)
unnamed: R23.1, RV4.1
unnamed: R24.1, RV5.1
unnamed: R26.1, R27.1, RV6.1, U8.9 (-)
OUT: C22.2, U8.13 (-), U8.14
VCC: L3.1
VCC2: C18.1, L3.2, R18.1, R19.1, RV3.1, U8.4 (V+)
Vref: R21.2, RV3.2, U8.5 (+), U8.10 (+)
