cdrfiuba/marciano/pcbs/basicmother/motordrv.sch

## KiCad design pcbs/basicmother/motordrv.sch (2015-04-25)


Parts:
C14, C16: 100n; C_Disc_D3_P2.5
C15: 10n; C_Disc_D3_P2.5
C17: 330 uF; C_Radial_D5_L6_P2.5
IC1: DRV8843; HTSSOP28
R12, R13, R14: 10k; Resistor_Horizontal_RM10mm
R15, R16: .47; Resistor_Horizontal_RM15mm
R17: 1M; Resistor_Horizontal_RM10mm

Connections:
DGND: C14.2, IC1.24 (AI0), IC1.25 (AI1), IC1.26 (BI0), IC1.27 (BI1), R14.2
DVDD: R12.1
INT33: C14.1, IC1.15 (V3P3OUT), R13.1
IN_A1: IC1.21 (AIN1)
IN_A2: IC1.20 (AIN2)
IN_B1: IC1.22 (BIN1)
IN_B2: IC1.23 (BIN2)
MOUT_A1: IC1.5 (AOUT1)
MOUT_A2: IC1.7 (AOUT2)
MOUT_B1: IC1.10 (BOUT1)
MOUT_B2: IC1.8 (BOUT2)
unnamed: C15.1, IC1.2 (CP2)
unnamed: C15.2, IC1.1 (CP1)
unnamed: C16.2, IC1.3 (VCP), R17.2
unnamed: IC1.6 (ISENA), R15.2
unnamed: IC1.9 (ISENB), R16.2
unnamed: IC1.12 (AVREF), IC1.13 (BVREF), R13.2, R14.1
unnamed: IC1.19 (DECAY), R12.2
PGND: C17.2, IC1.14 (GND), IC1.28 (GND), R15.1, R16.1
PVDD: C16.1, C17.1, IC1.4 (VMA), IC1.11 (VMB), R17.1
~FAULT: IC1.18 (nFAULT)
~RESET: IC1.16 (nRESET)
~SLEEP: IC1.17 (nSLEEP)

Notes on the sheet:
Power and motor connections
Control singals
Signals to microcontroller
