cdrfiuba/marciano/pcbs/basicmother/power.sch

## KiCad design pcbs/basicmother/power.sch (2015-04-25)


Parts:
C1, C2, C6: 100u; C_Radial_D5_L6_P2.5
C3: 100n; C_Disc_D3_P2.5
C4, C5: 22n; C_Rect_L7_W2_P5
C7: 10u; C_Radial_D5_L6_P2.5
P5: SWITCH; Socket_Strip_Straight_1x02
P6: BATT; bornier2
P11: BATT; molex_2_recto
R2: 1.35k; Resistor_Horizontal_RM10mm
R3: 1.07k; Resistor_Horizontal_RM10mm
R4: 5.62k; Resistor_Horizontal_RM10mm
R5: 100k; Resistor_Horizontal_RM10mm
U4: PTN4050; PTN04050C-EUU
U5: LMZ12002; PFM7

Connections:
+5V: C1.1, C5.2, C6.1, R4.1, U4.2 (VI), U5.7 (VOUT)
+12V: C2.1, C3.1, U4.4 (VO)
+15V: C7.1, P5.2, R5.1, U5.1 (VIN)
+BATT: P5.1, P6.1, P11.1
GND: C1.2, C2.2, C3.2, C4.2, C6.2, C7.2, P6.2, P11.2, R2.2, R3.2, U4.1 (GND), U5.4 (GND)
unnamed: C4.1, U5.5 (SS)
unnamed: C5.1, R3.1, R4.2, U5.6 (FB)
unnamed: R2.1, U4.3 (Adj.)
unnamed: R5.2, U5.2 (RON)

Notes on the sheet:
Bajar de 14.8 a 5
Elevar de 5 a 12 con PTN04050c
CONECTOR DE BATERIA
CONECTOR DE ENCENDIDO
