cdrfiuba/marciano/pcbs/basicmother/sound.sch

## KiCad design pcbs/basicmother/sound.sch (2015-04-25)


Parts:
C8, C9: 390n; C_Disc_D3_P2.5
C10, C11: 10u; C_Radial_D5_L6_P2.5
C12, C13: 1u; C_Rect_L18_W5_P15
L1, L2: 1uH; Resistor_Horizontal_RM10mm
P7: SPK1; Socket_Strip_Straight_1x02
P8: SPK2; Socket_Strip_Straight_1x02
R6, R7, R8, R9, R10, R11: 22k; Resistor_Horizontal_RM10mm
RV1, RV2: 50k; Socket_Strip_Straight_1x03
U6, U7: LM4950TS; TO-263

Connections:
GND: C10.2, C11.2, C12.1, C13.1, U6.4 (GND), U6.5 (GND), U6.10 (TAP), U7.4 (GND), U7.5 (GND), U7.10 (TAP)
IN: C8.2, C9.2
unnamed: C8.1, R6.2
unnamed: C9.1, R7.2
unnamed: C10.1, U6.8 (BP)
unnamed: C11.1, U7.8 (BP)
unnamed: C12.2, L1.1, U6.6 (VDD)
unnamed: C13.2, L2.1, U7.6 (VDD)
unnamed: P7.1, R8.1, R10.1, U6.3 (OUTA)
unnamed: P7.2, RV1.1, RV1.2, U6.7 (OUTB)
unnamed: P8.1, R9.1, R11.1, U7.3 (OUTA)
unnamed: P8.2, RV2.1, RV2.2, U7.7 (OUTB)
unnamed: R8.2, RV1.3, U6.9 (INB)
unnamed: R9.2, RV2.3, U7.9 (INB)
unnamed: R6.1, R10.2, U6.1 (INA)
unnamed: R7.1, R11.2, U7.1 (INA)
VIN: L1.2, L2.2
~SHD: U6.2 (~SHD~), U7.2 (~SHD~)
