cdrfiuba/marciano/pcbs/control_remoto/Parlante.sch

## KiCad design pcbs/control_remoto/Parlante.sch (2015-04-25)

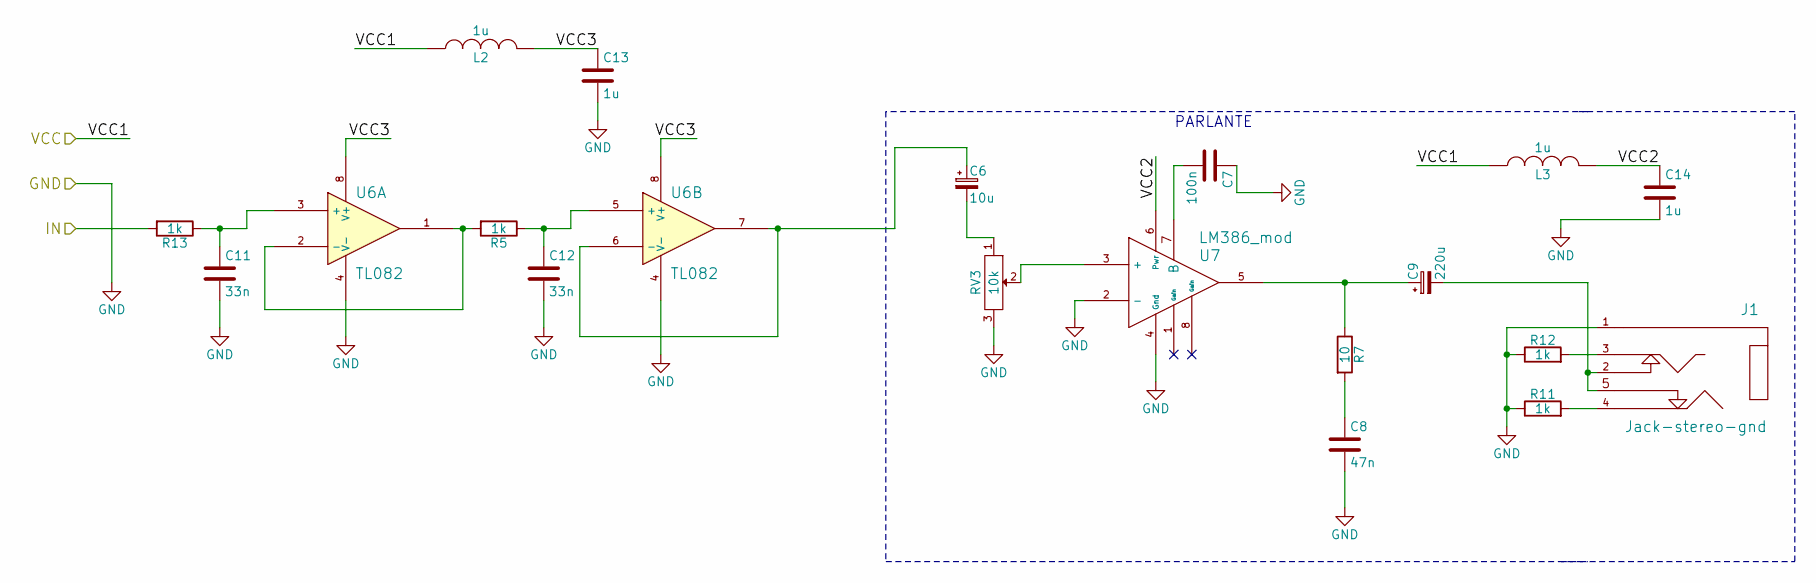
[picture p20: schematic Parlante.sch]

Parts:
C6: 10u; C_Radial_D5_L6_P2.5
C7: 100n; C_Disc_D3_P2.5
C8: 47n; C_Disc_D3_P2.5
C9: 220u; C_Radial_D5_L6_P2.5
C11, C12: 33n; C_Rect_L7_W2_P5
C13, C14: 1u; C_Rect_L18_W5_P15
J1: Jack-stereo-gnd; audio-jack-stereo
L2, L3: 1u; Resistor_Horizontal_RM10mm
R5, R11, R12, R13: 1k; Resistor_Horizontal_RM10mm
R7: 10; Resistor_Horizontal_RM10mm
RV3: 10k; Pin_Header_Straight_1x03
U6: TL082; DIP-8__300_ELL
U7: LM386_mod; DIP-8__300_ELL

Connections:
GND: C7.1, C8.2, C11.2, C12.2, C13.2, C14.2, J1.1, R11.1, R12.1, RV3.3, U6.4 (V-), U7.2 (-), U7.4 (Gnd)
IN: R13.2
unnamed: C6.1, U6.6 (-), U6.7
unnamed: C6.2, RV3.1
unnamed: C7.2, U7.7 (B)
unnamed: C8.1, R7.2
unnamed: C9.1, R7.1, U7.5
unnamed: C9.2, J1.2, J1.5
unnamed: C11.1, R13.1, U6.3 (+)
unnamed: C12.1, R5.1, U6.5 (+)
unnamed: J1.3, R12.2
unnamed: J1.4, R11.2
unnamed: R5.2, U6.1, U6.2 (-)
unnamed: RV3.2, U7.3 (+)
VCC: L2.1, L3.1
VCC2: C14.1, L3.2, U7.6 (Pwr)
VCC3: C13.1, L2.2, U6.8 (V+)

Notes on the sheet:
PARLANTE
