cdrfiuba/marciano/pcbs/control_remoto/controlremoto.sch

## KiCad design pcbs/control_remoto/controlremoto.sch (2015-11-07, an earlier design)

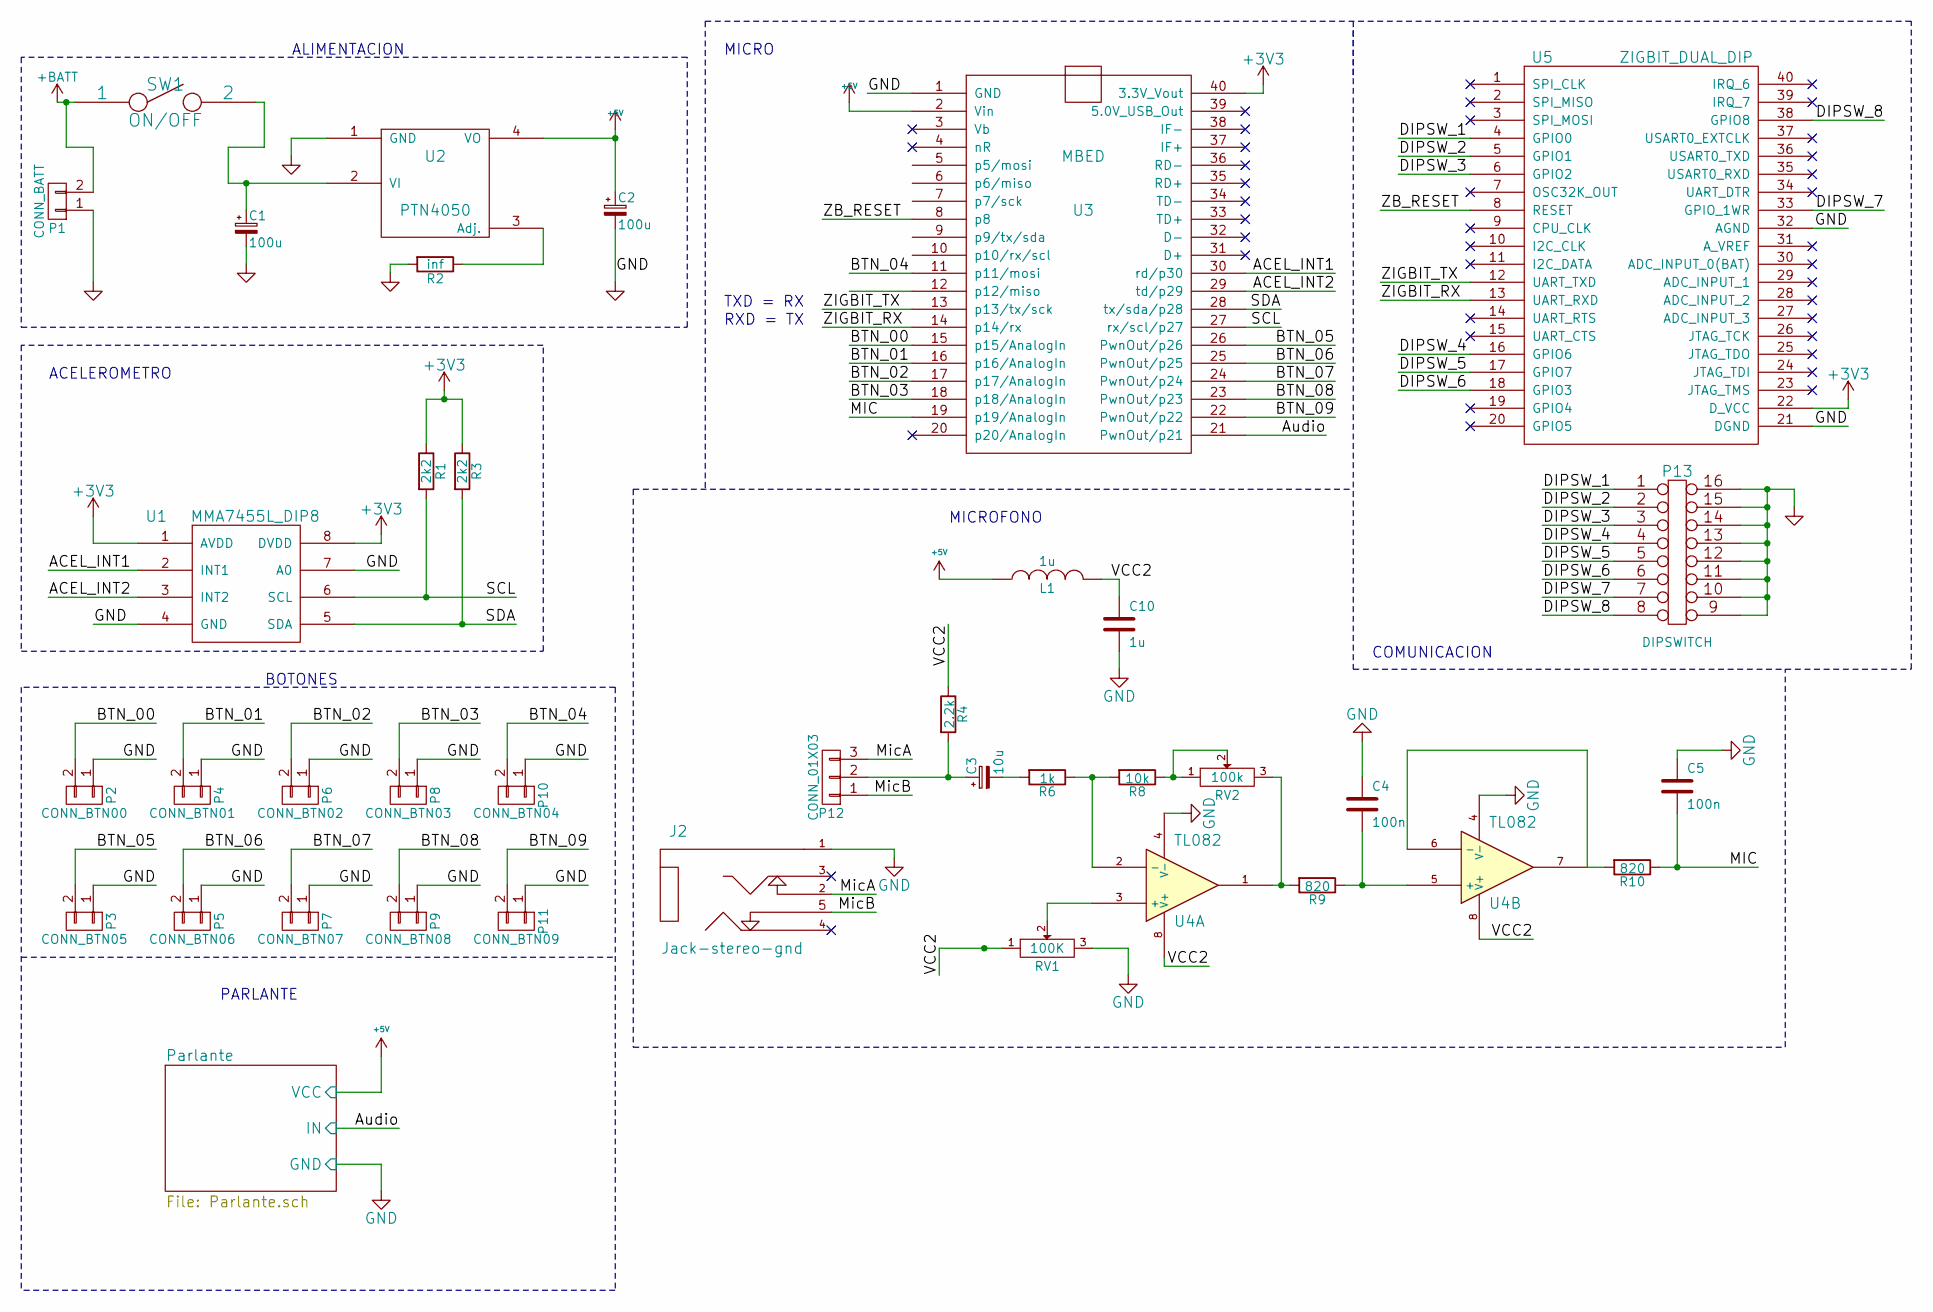
[picture p21: schematic controlremoto.sch]

Parts:
C1, C2: 100u; C_Radial_D5_L6_P2.5
C3: 10u; C_Radial_D5_L6_P2.5
C4, C5: 100n; C_Rect_L7_W2_P5
C10: 1u; C_Rect_L18_W5_P15
J2: Jack-stereo-gnd; audio-jack-stereo
L1: 1u; Resistor_Horizontal_RM10mm
P1: CONN_BATT; molex_2_recto
P2: CONN_BTN00; Pin_Header_Straight_1x02
P3: CONN_BTN05; Pin_Header_Straight_1x02
P4: CONN_BTN01; Pin_Header_Straight_1x02
P5: CONN_BTN06; Pin_Header_Straight_1x02
P6: CONN_BTN02; Pin_Header_Straight_1x02
P7: CONN_BTN07; Pin_Header_Straight_1x02
P8: CONN_BTN03; Pin_Header_Straight_1x02
P9: CONN_BTN08; Pin_Header_Straight_1x02
P10: CONN_BTN04; Pin_Header_Straight_1x02
P11: CONN_BTN09; Pin_Header_Straight_1x02
P12: CONN_01X03; Socket_Strip_Straight_1x03
P13: DIPSWITCH; DIP-16__300_ELL
R1, R3: 2k2; Resistor_Horizontal_RM10mm
R2: inf; Resistor_Horizontal_RM10mm
R4: 2.2k; Resistor_Horizontal_RM10mm
R6: 1k; Resistor_Horizontal_RM10mm
R8: 10k; Resistor_Horizontal_RM10mm
R9, R10: 820; Resistor_Horizontal_RM10mm
RV1: 100K; Pin_Header_Straight_1x03
RV2: 100k; Pin_Header_Straight_1x03
SW1: ON/OFF; Pin_Header_Straight_1x02
U1: MMA7455L_DIP8; DIP-8__300_ELL
U2: PTN4050; PTN04050C-EUU
U3: MBED
U4: TL082; DIP-8__300_ELL
U5: ZIGBIT_DUAL_DIP; ZIGBIT_DIP_40

Connections:
+3V3: R1.1, R3.1, U1.1 (AVDD), U1.8 (DVDD), U3.40 (3.3V_Vout), U5.22 (D_VCC)
+5V: C2.1, L1.1, U2.4 (VO), U3.2 (Vin)
+BATT: P1.2, SW1.1
ACEL_INT1: U1.2 (INT1), U3.30 (rd/p30)
ACEL_INT2: U1.3 (INT2), U3.29 (td/p29)
Audio: U3.21 (PwnOut/p21)
BTN_00: P2.2, U3.15 (p15/AnalogIn)
BTN_01: P4.2, U3.16 (p16/AnalogIn)
BTN_02: P6.2, U3.17 (p17/AnalogIn)
BTN_03: P8.2, U3.18 (p18/AnalogIn)
BTN_04: P10.2, U3.11 (p11/mosi)
BTN_05: P3.2, U3.26 (PwnOut/p26)
BTN_06: P5.2, U3.25 (PwnOut/p25)
BTN_07: P7.2, U3.24 (PwnOut/p24)
BTN_08: P9.2, U3.23 (PwnOut/p23)
BTN_09: P11.2, U3.22 (PwnOut/p22)
DIPSW_1: P13.1, U5.4 (GPIO0)
DIPSW_2: P13.2, U5.5 (GPIO1)
DIPSW_3: P13.3, U5.6 (GPIO2)
DIPSW_4: P13.4, U5.16 (GPIO6)
DIPSW_5: P13.5, U5.17 (GPIO7)
DIPSW_6: P13.6, U5.18 (GPIO3)
DIPSW_7: P13.7, U5.33 (GPIO_1WR)
DIPSW_8: P13.8, U5.38 (GPIO8)
GND: C1.2, C2.2, C4.1, C5.1, C10.2, J2.1, P1.1, P2.1, P3.1, P4.1, P5.1, P6.1, P7.1, P8.1, P9.1, P10.1, P11.1, P13.9, P13.10, P13.11, P13.12, P13.13, P13.14, P13.15, P13.16, R2.2, RV1.3, U1.4 (GND), U1.7 (A0), U2.1 (GND), U3.1 (GND), U4.4 (V-), U5.21 (DGND), U5.32 (AGND)
MIC: C5.2, R10.1, U3.19 (p19/AnalogIn)
MicA: J2.2, P12.3
MicB: J2.5, P12.1
unnamed: C1.1, SW1.2, U2.2 (VI)
unnamed: C3.1, P12.2, R4.2
unnamed: C3.2, R6.2
unnamed: C4.2, R9.1, U4.5 (+)
unnamed: R2.1, U2.3 (Adj.)
unnamed: R6.1, R8.2, U4.2 (-)
unnamed: R8.1, RV2.1, RV2.2
unnamed: R9.2, RV2.3, U4.1
unnamed: R10.2, U4.6 (-), U4.7
unnamed: RV1.2, U4.3 (+)
SCL: R1.2, U1.6 (SCL), U3.27 (rx/scl/p27)
SDA: R3.2, U1.5 (SDA), U3.28 (tx/sda/p28)
VCC2: C10.1, L1.2, R4.1, RV1.1, U4.8 (V+)
ZB_RESET: U3.8 (p8), U5.8 (RESET)
ZIGBIT_RX: U3.14 (p14/rx), U5.13 (UART_RXD)
ZIGBIT_TX: U3.13 (p13/tx/sck), U5.12 (UART_TXD)

Notes on the sheet:
RXD = TX
TXD = RX
BOTONES
ALIMENTACION
ACELEROMETRO
COMUNICACION
MICRO
MICROFONO
PARLANTE
