cdrfiuba/marciano/pcbs/eyesunicolor/eyesunicolor.sch

## KiCad design pcbs/eyesunicolor/eyesunicolor.sch (2015-04-25)

Schematic: eyesunicolor.sch

Parts:
C1, C2: 100n
D1, D2, D4, D5, D6, D7, D8, D9, D10, D11, D12, D13, D14, D15, D16, D17, D18, D19, D20, D21, D22, D23, D24, D25, D26, D27, D28, D29, D31, D32: LED
D3, D30: LED
J1, J2: SUPP28
P1, P2, P3: CONN_5X2
R1, R3: 2.2k
R2, R4: 10k

Notes on the sheet:
Ojo Derecho
Conector que viene desde el micro
Conector que va al ojo izquierdo
Ojo Izquierdo
