cdrfiuba/marciano/src/eyes/MatthewPandina/code/rgb-pov/firmware/data.c

#include "data.h"

uint16_t pov_width = 64;
uint16_t pov_height = 64;

uint8_t pov[][3][96] PROGMEM = {
{
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
},
};
