cdrfiuba/marciano/(commit log)

2013-07-13 agrego una version que usa el driver de leds
2013-08-23 Agrego el c?digo que hizo el sr. Matthew Padina sobre el TLC 5940
    [multiplexing-multi.sch, multiplexing.sch, no_border.sch, no_border_multiple.sch, usart_mspim-multiplexing-multi.sch, usart_mspim-multiplexing.sch, usart_mspim-no_border.sch, usart_mspim-no_border_multiple.sch]
2013-08-23 cambios menores en el codigo
2013-08-24 Probe el ch3, cambio en Makefile y main.c
2013-08-31 Probamos el codigo del ch4, falta setear el FUSE del clock; Agregamos un resistencia al protoboard para bajar la intensidad de los leds; Modificamos el archivo main.c de los ch4 y ch3 para que se enc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
2013-09-07 Ajustamos los clocks, cambiamos los main.c de los capitulos 3 y 4
2013-09-14 Realizacion de esquematico
    [eyesunicolor.kicad_pcb, eyesunicolor.sch, no_border_multiple.sch]
2013-09-21 Dise?o de placa. Acomodamos los leds.
    [eyesunicolor.kicad_pcb, eyesunicolor.sch]
2013-10-05 Termine la placa. Hay que optimizarla.
    [eyesunicolor.kicad_pcb, eyesunicolor.sch]
2013-10-19 Se termino el PCB del ojo izquierdo, se comenzo a trabajar con el ojo derecho
    [eyesunicolor.kicad_pcb, eyesunicolor.sch]
2013-10-26 Arme el pcb del ojo derecho. Falta termiar
    [eyesunicolor.kicad_pcb, eyesunicolor.sch]
2013-11-09 Intente terminar los ojos, pero no puedo co el ojo derecho. TERMINAR URGENTE
    [eyesunicolor.kicad_pcb, eyesunicolor.sch]
2013-11-16 Elimino archivos de backup y actualizo pcb y schm
    [eyesunicolor.kicad_pcb, eyesunicolor.sch]
2013-11-18 agrego los bordes y mas agujeros de montaje
    [eyesunicolor.kicad_pcb]
2013-11-18 cambio la hoja a A4 y agrego rotulo
    [eyesunicolor.kicad_pcb]
2013-11-18 agrego nuestros nombres en el PCB
    [eyesunicolor.kicad_pcb]
2013-12-20 Agrego el codigo que funciona como test de los ojitos
2013-12-21 Arreglo la falla de VCC
    [eyesunicolor.kicad_pcb]
2014-01-10 Creamos carpeta para nueva placa
2014-01-10 Agrego modulo de zigbit
2014-01-11 Esquematico para placa basicmother
2014-01-31 primera prueba de leds
2014-01-31 Te paso el esquematico :)
    [basicmother.sch]
2014-02-01 Expresiones de los ojos
2014-04-26 Agrego el codigo de control del robot con libmanyuc
2014-04-26 Ajusto el clock y agrego una linea para que indique el tamanio del archivo
2014-04-26 Primera version de la placa madre y sigo agregando bibliotecas
    [basicmother.sch]
2014-04-26 elimino archivos de cache
2014-04-26 emprolije eyes.c y el encabezado de la biblioteca de tlc5940
2014-04-26 Move eyes code to its directory.
    It also adds a main.c which listens to usart command and changes the
    eyes modes.
    [basicmother.sch, eyesunicolor.kicad_pcb, eyesunicolor.sch, multiplexing-multi.sch, multiplexing.sch, no_border.sch, usart_mspim-multiplexing-multi.sch, usart_mspim-multiplexing.sch]
2014-04-26 Modes are not working.
    [main.c]
2014-05-01 Ordenamos todos los modos de los ojos, falta corregir blink y tired
2014-05-01 Ajustamos el programa de los ojos e incluimos el codigo de cambiar modo de ojos al codigo de mbed car
2014-05-05 * Agregamos la biblioteca del acelerometro (Ariel) * Modificaciones previas a la feria del libro para controlar los ojos desde el control remoto
2014-10-07 Agrego un led de debug de serie y hago que los ojos se inicialicen en el modo 0.
2015-02-07 Actualizando la nueva placa base, falta el amplificador para el parlante
    [basicmother.sch, power.sch]
2015-03-11 actualizo la placa principal
    [basicmother.sch, power.sch]
2015-03-13 agrego archivos faltantes
    [motordrv.sch, sound.sch]
2015-03-14 Dise?o del pcb del nuevo contro remoto
    [controlremoto.brd, controlremoto.sch]
2015-03-14 Asociacion de componentes
    [controlremoto.sch]
2015-04-04 Actualizo esquematico de la placa principal y empiezo con el layout
    [basicmother.kicad_pcb, basicmother.sch, controlremoto.brd, controlremoto.sch, eyesunicolor.kicad_pcb, eyesunicolor.sch, motordrv.sch, multiplexing-multi.sch]
2015-04-08 Actualic? el esquematico del control remoto
    [controlremoto.sch]
2015-04-11 Fin esquematico pcb control remoto
    [controlremoto.sch]
2015-04-11 Agrego parlante
    [Parlante.sch]
2015-04-11 agrego algunos cambios en el control y casi termino la placa principal
    [Parlante.sch, basicmother.sch, controlremoto.sch, motordrv.sch, power.sch, sound.sch]
2015-04-11 agrego la parte del microfono de la placa principal
    [mic.sch]
2015-04-15 completo el esquematico del control y asigno footprints
    [Parlante.sch, basicmother.sch, controlremoto.kicad_pcb, controlremoto.sch, mic.sch, motordrv.sch, power.sch, sound.sch]
2015-04-18 Placa Control remoto
    [controlremoto.kicad_pcb]
2015-04-18 Actualizo el esquematico de la placa principal
    [Parlante.sch, basicmother.kicad_pcb, basicmother.sch, controlremoto.brd, controlremoto.kicad_pcb, controlremoto.sch, eyesunicolor.kicad_pcb, eyesunicolor.sch]
2015-04-18 Actualizo el parlante
    [Parlante.sch]
2015-04-19 Agrego la placa de control de los ojitos, separada de la principal
    [Parlante.sch, basicmother.kicad_pcb, basicmother.sch, controlremoto.brd, controlremoto.kicad_pcb, controlremoto.sch, eyescontrol.kicad_pcb, eyescontrol.sch]
2015-04-19 saque el micro para el control de los ojitos y lo pase a una placa aparte, ademas agregue un doble microfono
    [basicmother.kicad_pcb, basicmother.sch, mic.sch, motordrv.sch, power.sch, sound.sch]
2015-04-19 Placa control
    [controlremoto.kicad_pcb]
2015-04-19 borro archivos de mas
2015-04-20 primera version del pcb de la placa principal, falta verificar footprints
    [basicmother.kicad_pcb, basicmother.sch, eyescontrol.sch, mic.sch]
2015-04-20 primera version del control, falta verificar footprint
    [Parlante.sch, controlremoto.kicad_pcb, controlremoto.sch]
2015-04-21 actualizo las 3 placas, revisar y mandar a fabricar
    [Parlante.sch, basicmother.kicad_pcb, basicmother.sch, controlremoto.brd, controlremoto.kicad_pcb, controlremoto.sch, eyescontrol.kicad_pcb, eyescontrol.sch]
2015-04-25 Agrego primer version del sporte para control remoto
    [Parlante.sch, basicmother.kicad_pcb, basicmother.sch, controlremoto.brd, controlremoto.kicad_pcb, controlremoto.sch, eyescontrol.kicad_pcb, eyescontrol.sch]
2015-04-25 Finished first version of the remote_control_holder
    [remote_control_holder_v1.scad]
2015-04-25 Changed thickness of the remote_control_holder
    [remote_control_holder_v1.scad]
2015-04-26 Changed remote control holder for being more ergonomic, adjusted holes, buttons spacing and grip diameter
    [remote_control_holder.scad, remote_control_holder_v1.scad]
2015-04-26 Added the name 'MARCIANO' to the remote control grip part. Added needed files
    [Letters.dxf, Write.scad, orbitron.dxf, remote_control_holder.scad]
2015-04-26 Adjusted hole size, added rounded corner. Mirrored for right hand too.
    [remote_control_holder.scad]
2015-11-07 actualizo el codigo de los ojitos
2015-11-07 cambios hechos en las placas
    [basicmother.kicad_pcb, basicmother.sch, controlremoto.kicad_pcb, controlremoto.sch, eyescontrol.kicad_pcb]
